dllgxhy/ElectriSmell/hardware/v50/工作流程图.pdf

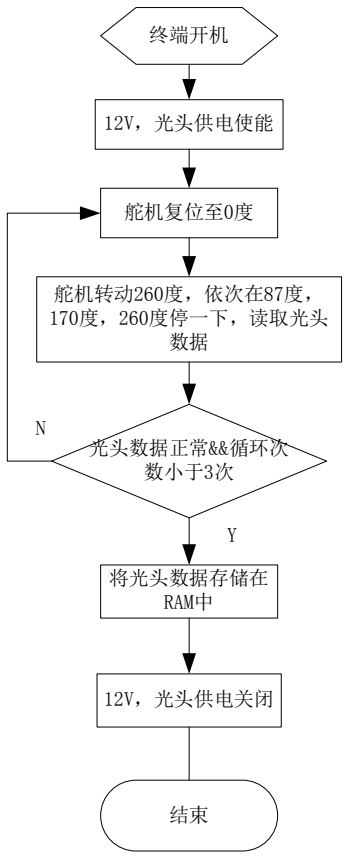
[picture p2: figure]
终端开机; 舵机复位至0度; 舵机转动260度，依次在87度， 170度，260度停一下，读取光头 数据; 光头数据正常&&循环次 数小于3次; 将光头数据存储在 RAM中; 12V，光头供电使能; 12V，光头供电关闭

开机流程

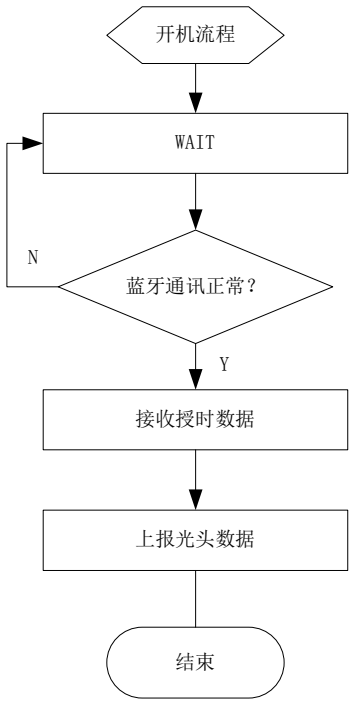
[picture p3: figure]
开机流程; 蓝牙通讯正常？; WAIT; 接收授时数据; 上报光头数据

接收

蓝牙联通流程

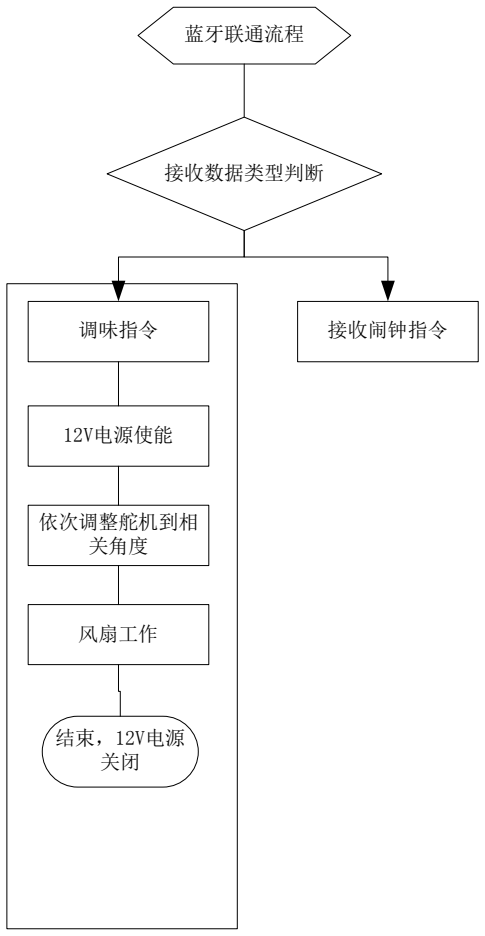
[picture p4: figure]
蓝牙联通流程; 接收数据类型判断; 调味指令; 接收闹钟指令; 12V电源使能; 依次调整舵机到相 关角度; 风扇工作; 结束，12V电源 关闭

调味流程中的每个流程都可以被蓝牙数据打断，重新工作

如：控制3个舵机全部转到260度，风扇需工作时间180s，目 前舵机已转到位置，风扇工作了15s,而此时蓝牙端接收到命 令 控制舵机转到177度，风扇工作70s，则此时执行新命令
