dllgxhy/ElectriSmell/hardware/v30/bom.xls

物料清单
文件编号: |  |  | 文件版本:V1.0
主板模块V2.0 物料编码: |  |  |  |  |  | 购买链接 | 单价 | 采购数量
1 | PCB |  |  | 1
电容
2 | 电容 | 100nF ±10% 0603 | C25,C27,C29,C38,C40,C44,C48,C50,C53,C25,C27,C29,C38,C40,C44,C48,C50,C53,C57 | 19 |  | http://www.szlcsc.com/product/details_2040.html | 24.8元/盘 | 300 | ok
4 | 电容 | 10nF ±10% 0603 | C7,C8,C24 | 3 |  | http://www.szlcsc.com/product/details_27151.html | 29元/盘 | 100 | ok
6 | 电容 | 100pF ±20% 50v 0603 | C13 | 1 |  | http://www.szlcsc.com/product/details_45569.html | 24.8元/盘 | 150 | ok
7 | 电容 | 10uF ±%10 0603 | C9,C10,C26,C28,C30,C37,C39,C41,C42,C45,C46,C51,C54,C56,C58,C60,C17,C19,C21,C23 | 20 |  | http://www.szlcsc.com/product/details_2043.html | 94元/盘 | 300 | ok
8 | 电容 | 1uF ±10% 0603 | C16,C18,C20,C22,C43,C47,C52,C55,C59 | 9 |  | http://www.szlcsc.com/product/details_37555.html | 22元/盘 | 200 | ok
9 | 电容 | 20pF ±5% 0603 | C11,C14 | 2 |  | http://www.szlcsc.com/product/details_2000.html | 23.2元/盘 | 200 | ok
12 | 电容 | 6.2pF ±5% 0603 | C12,C15 | 2 |  | http://www.szlcsc.com/product/details_2030.html | 24.8元/盘 | 100 | OK
电阻
13 | 电阻 | 300Ω ±5% 0603 | R49 | 1 |  | http://www.szlcsc.com/product/details_25972.html | 11元/盘 | 100 | OK
14 | 电阻 | 3.9KΩ ±5% 0603 | R48 | 1 |  | http://www.szlcsc.com/product/details_26740.html | 11元/盘 | 100 | OK
15 | 电阻 | 0Ω ±5% 0603 | R23,R29,R33,R18,R19,R22,R25,R26,R28,R32 | 10 |  | http://www.szlcsc.com/product/details_16080.html | 11元/盘 | 200 | OK
16 | 电阻 | 0Ω ±5% 0805 | R47 | 1 | 正式使用时不焊接 | http://www.szlcsc.com/product/details_26018.html | 21 | 100 | OK
17 | 电阻 | 100K ±1% 0603 | R24,R30,R34 | 3 |  | http://www.szlcsc.com/product/details_16137.html | 18.5/盘 | 100 | OK
18 | 电阻 | 100Ω ±1% 0603 | R39,R41,R44,R50 | 4 |  | http://www.szlcsc.com/product/details_23502.html | 13/盘 | 200 | OK
21 | 电阻 | 10KΩ ±1% 0603 | R46,R10,R11,R12,R14,R15,R16,R17 | 8 |  | http://www.szlcsc.com/product/details_16079.html | 11/盘 | 200 | OK
22 | 电阻 | 330Ω ±5% 0603 | R40,R42,R45 | 3 |  | http://www.szlcsc.com/product/details_25974.html | 11/盘 | 100 | OK
23 | 电阻 | 220K ±5% 0603 | R43 | 1 |  | http://www.szlcsc.com/product/details_26330.html | 11/盘 | 100 | OK
24 | 电阻 | 1MΩ ±5% 0603 | R20 | 1 |  | http://www.szlcsc.com/product/details_26841.html | 11/盘 | 100 | OK
25 | 磁珠 | 100M 600Ω DCR<0.2ohm L0603 | L1 | 1 |  | http://www.szlcsc.com/product/details_29860.html | 53.6/盘 | 50 | OK
26 | LED | LED 蓝色 0603 | D9 | 1 |  | http://www.szlcsc.com/product/details_2661.html | 112/盘 | 40 | OK
27 | LED | LED 红色 0603 | D5,D7,D8,D6 | 4 |  | http://www.szlcsc.com/product/details_2659.html | 83.2/盘 | 100 | OK
28 | 晶振 | 8MHz,DIP,CL=8PF,HC49US | Y5 | 1 |  | http://www.szlcsc.com/product/details_21980.html | 50.4/盘 | 10 | OK
29 | 晶振 | 32.768KHz,3215 10ppm 12.5PF SMD | Y4 | 1 |  | http://www.szlcsc.com/product/details_71788.html | 189/盘 | 10
30 | 二极管 | RB160M-40 SOD123 | D2,D3,D4 | 3 |  | http://www.szlcsc.com/product/details_22279.html | 498/盘 | 50
IC
31 | PMU模块 | LM2577_M | U14 | 1 | 不焊接
32 | LDO | 78L05 SOT89 | U12 | 1 |  | http://www.szlcsc.com/product/details_43729.html | 1元/片 | 10 | OK
33 | LDO | ME6206A33 SOT23 | U11,U13,U15 | 3 |  | http://www.szlcsc.com/product/details_36232.html | 1元/片 | 10 | OK
34 | 充电IC | LN2054 | U10 | 1
35 | 模块 | BLE模块 | U7 | 1 | 不焊接
36 | 电机驱动芯片 | L9110S,SOP8 | U6,U8,U9 | 3 |  | https://detail.tmall.com/item.htm?id=40638558550&rn=196c9fb2bf3e426f6890c259c679c593&abbucket=13 | 6.5元/片 | 20 | OK
37 | 总线驱动芯片 | 74LVC4245A,TSSOP24 | U5 | 1 |  | http://www.szlcsc.com/product/details_6557.html | 2.39元/片 | 10 | OK
38 | MCU | STM32F103RCT6TR LQFP64 | U4 | 1 |  | https://detail.tmall.com/item.htm?id=19294790966&rn=550d37b9a9447904c1c20e33544b37f7&abbucket=13 | 16.46元/片 | 10 | OK
其他
39 | 按键 | 轻触开关 3*6*4.3mm SMD 250g | PWR1 | 3
40 | 按键 | 微型按钮自锁开关直插2脚带锁轻触按键开关电源8*8 | J15 | 3 | 不焊接 | https://item.taobao.com/item.htm?spm=a230r.1.14.16.pVWdSJ&id=522739128532&ns=1&abbucket=3#detail | 1.5元/个 | 20
41 | USB连接器 | MICRO-B-5P SMD | J13 | 1 |  | http://www.szlcsc.com/product/details_10961.html | 0.384元/个 | 10 | OK
42 | 锂电池 | RP601752P 500mAH(带保护板) | J12 | 1
43 | 舵机 |  | M1,M2,M3 | 3 | 不焊接
44 | 风扇 |  | J3,J4,J5 | 3 | 不焊接
45 | JTAG连接座 |  | J1 | 1 | 不焊接
固件程序:
程序名 | 固件版本号 |  | 烧写方式 |  | 备注
预装的文件
修 改 历 史 记 录
版本 | 修改日期 | 修改內容 |  |  | 备注
拟制: |  | 审核: | 批准:
