dllgxhy/ElectriSmell/hardware/v30/ELECTRISMELL0504.dxf

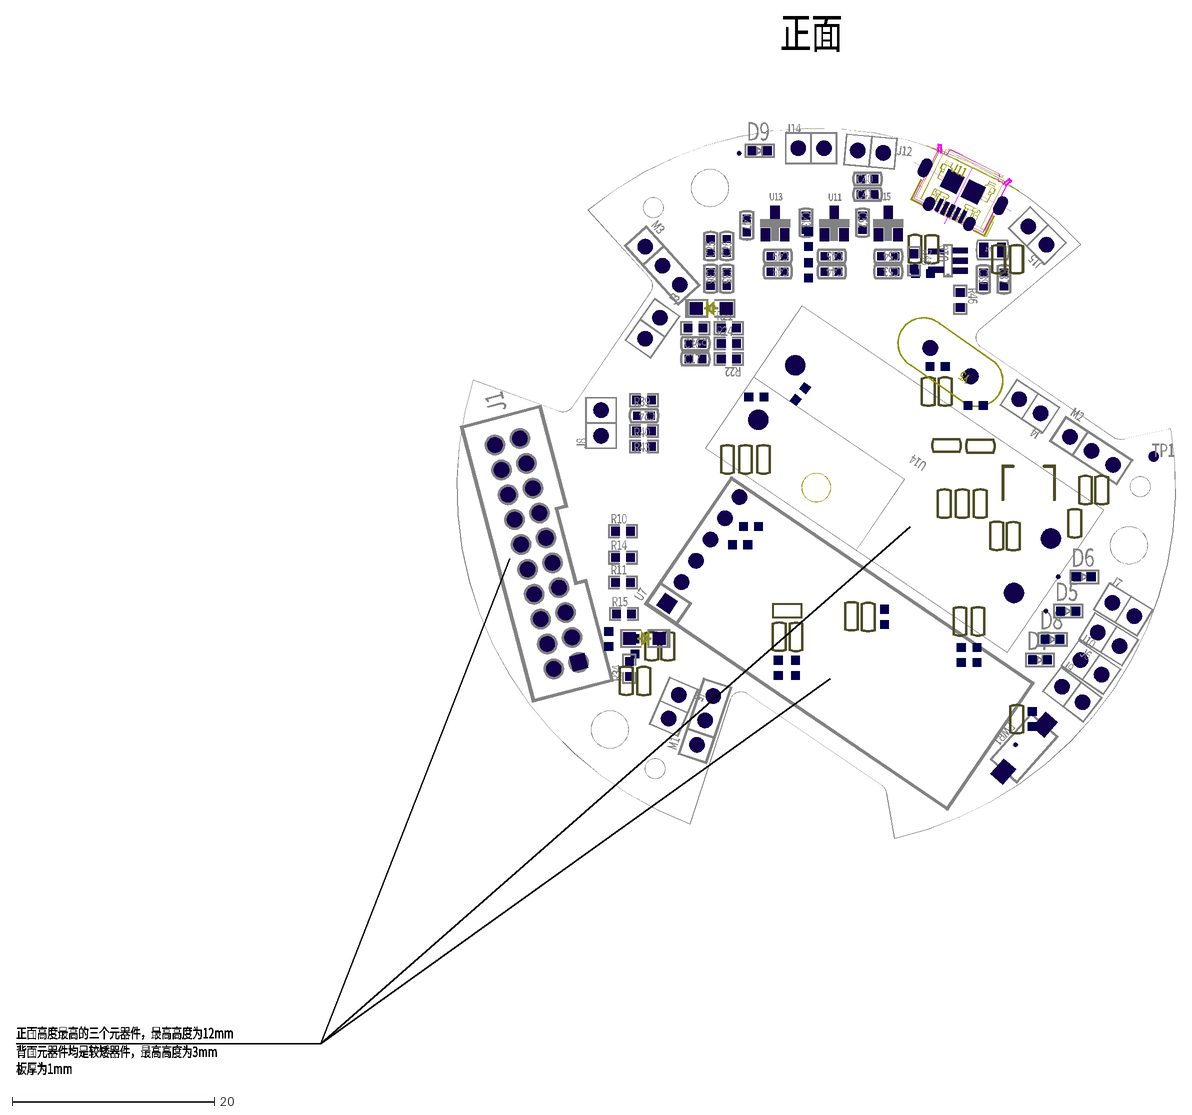
[picture p5: CAD file, 2016-07-26, an earlier design]
hardware/v30/ELECTRISMELL0504.dxf
J1
2
5
1
3
S2
S1
S3
S4
4
J11
U10
U14
U7
M1
M2
M3
PWR1
C16
C17
C24
C35
C36
J10
J12
J3
J4
J5
J6
J7
J8
J9
R10
R11
R14
R15
R39
R40
R43
R47
TP1
U11
U13
U15
Y5
J14
J15
R21
R34
C25
C26
C37
C39
C40
C41
C43
C44
C45
C47
C48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
