dllgxhy/ElectriSmell/hardware/v40/ELECTRISMELL_V40.dxf

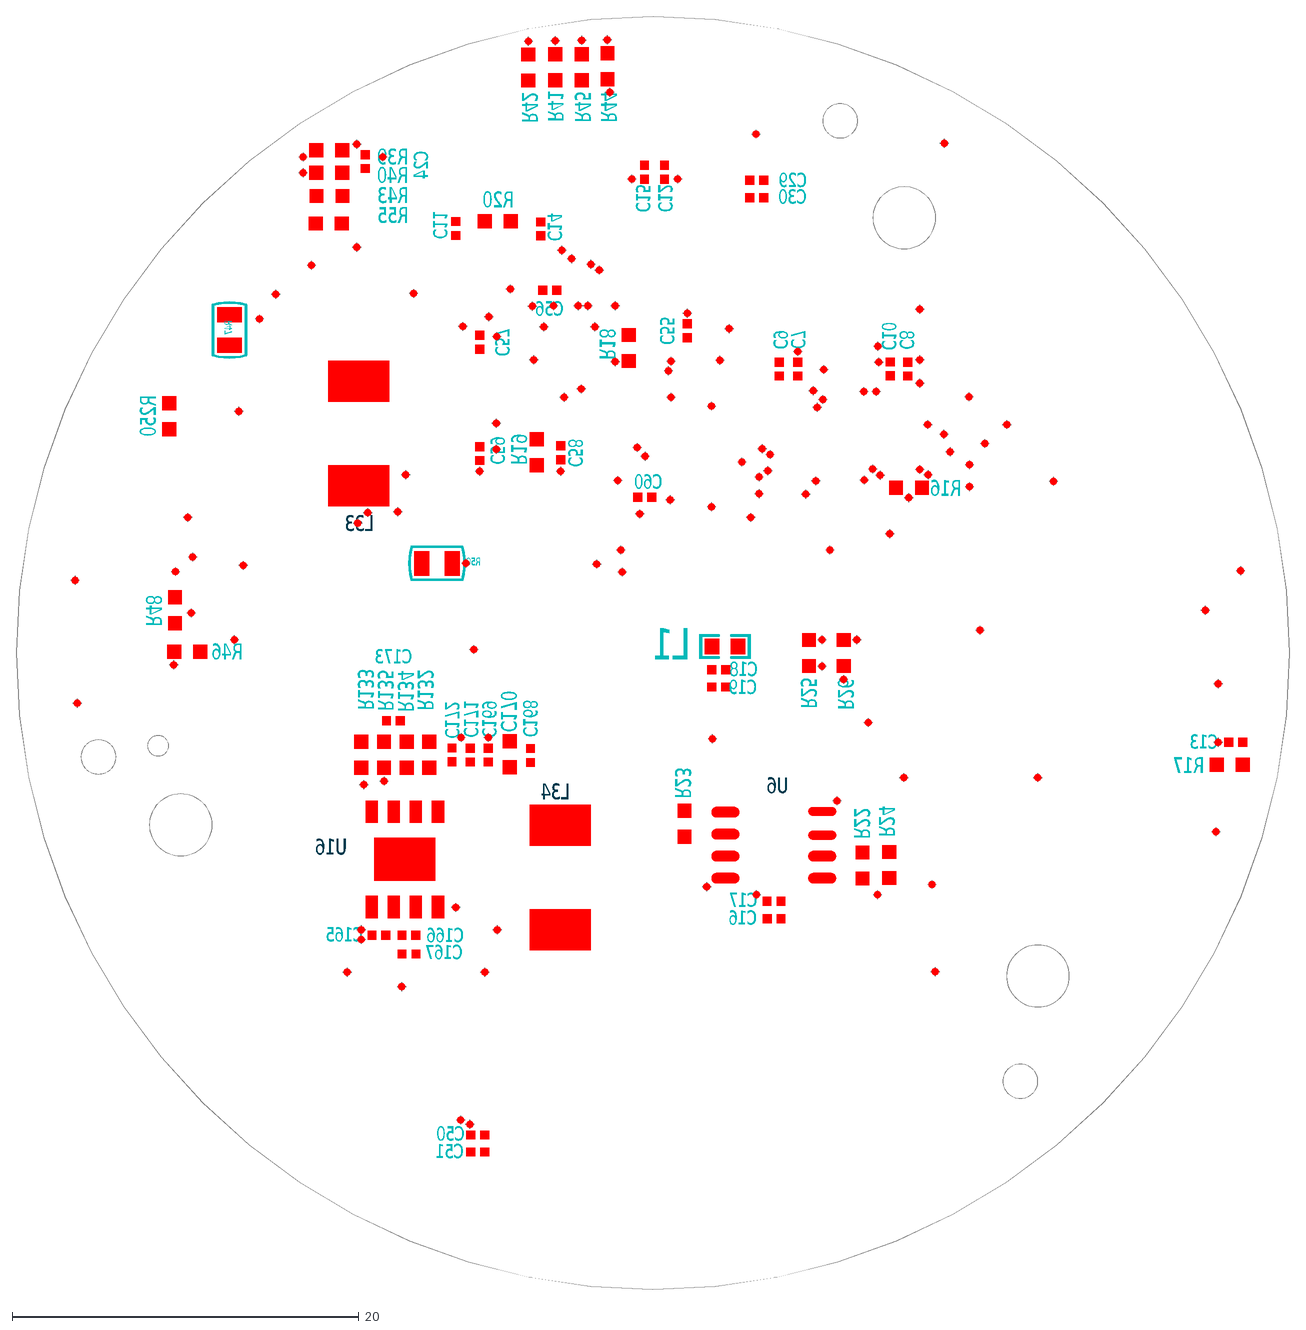
[picture p6: CAD file, 2016-07-26, an earlier design]
hardware/v40/ELECTRISMELL_V40.dxf
R39
C24
R43
R40
R55
C10
C11
C12
C13
C14
C15
C16
C165
C166
C167
C168
C169
C17
C170
C171
C172
C173
C18
C19
C29
C30
C50
C51
C55
C56
C57
C58
C59
C60
C7
C8
C9
L1
L33
L34
R132
R133
R134
R135
R16
R17
R18
R19
R20
R22
R23
R24
R25
R250
R26
R41
R42
R44
R45
R46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
