dllgxhy/ElectriSmell/hardware/v30/electrismell.pdf

D | D

# S T M3 2

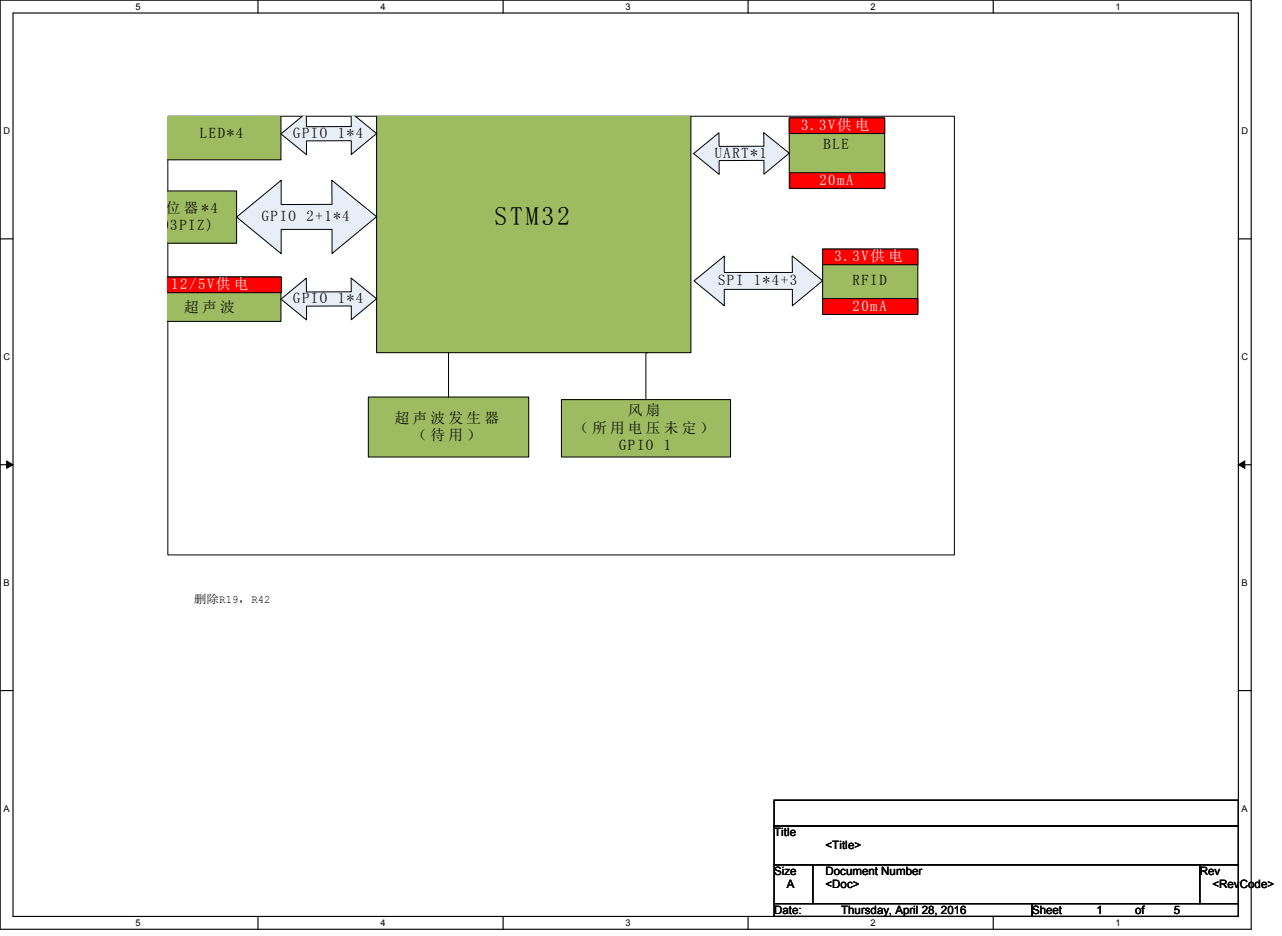
[picture p7: page 1]
UART*1; SPI 1*4+3; GPIO 1*4; GPIO 2+1*4; 删除R19，R42; Title; Size; Document Number; Rev; Date:; Sheet; <Doc>; <RevCode>; <Title>; Thursday, April 28, 2016

### JNTRST JTDI

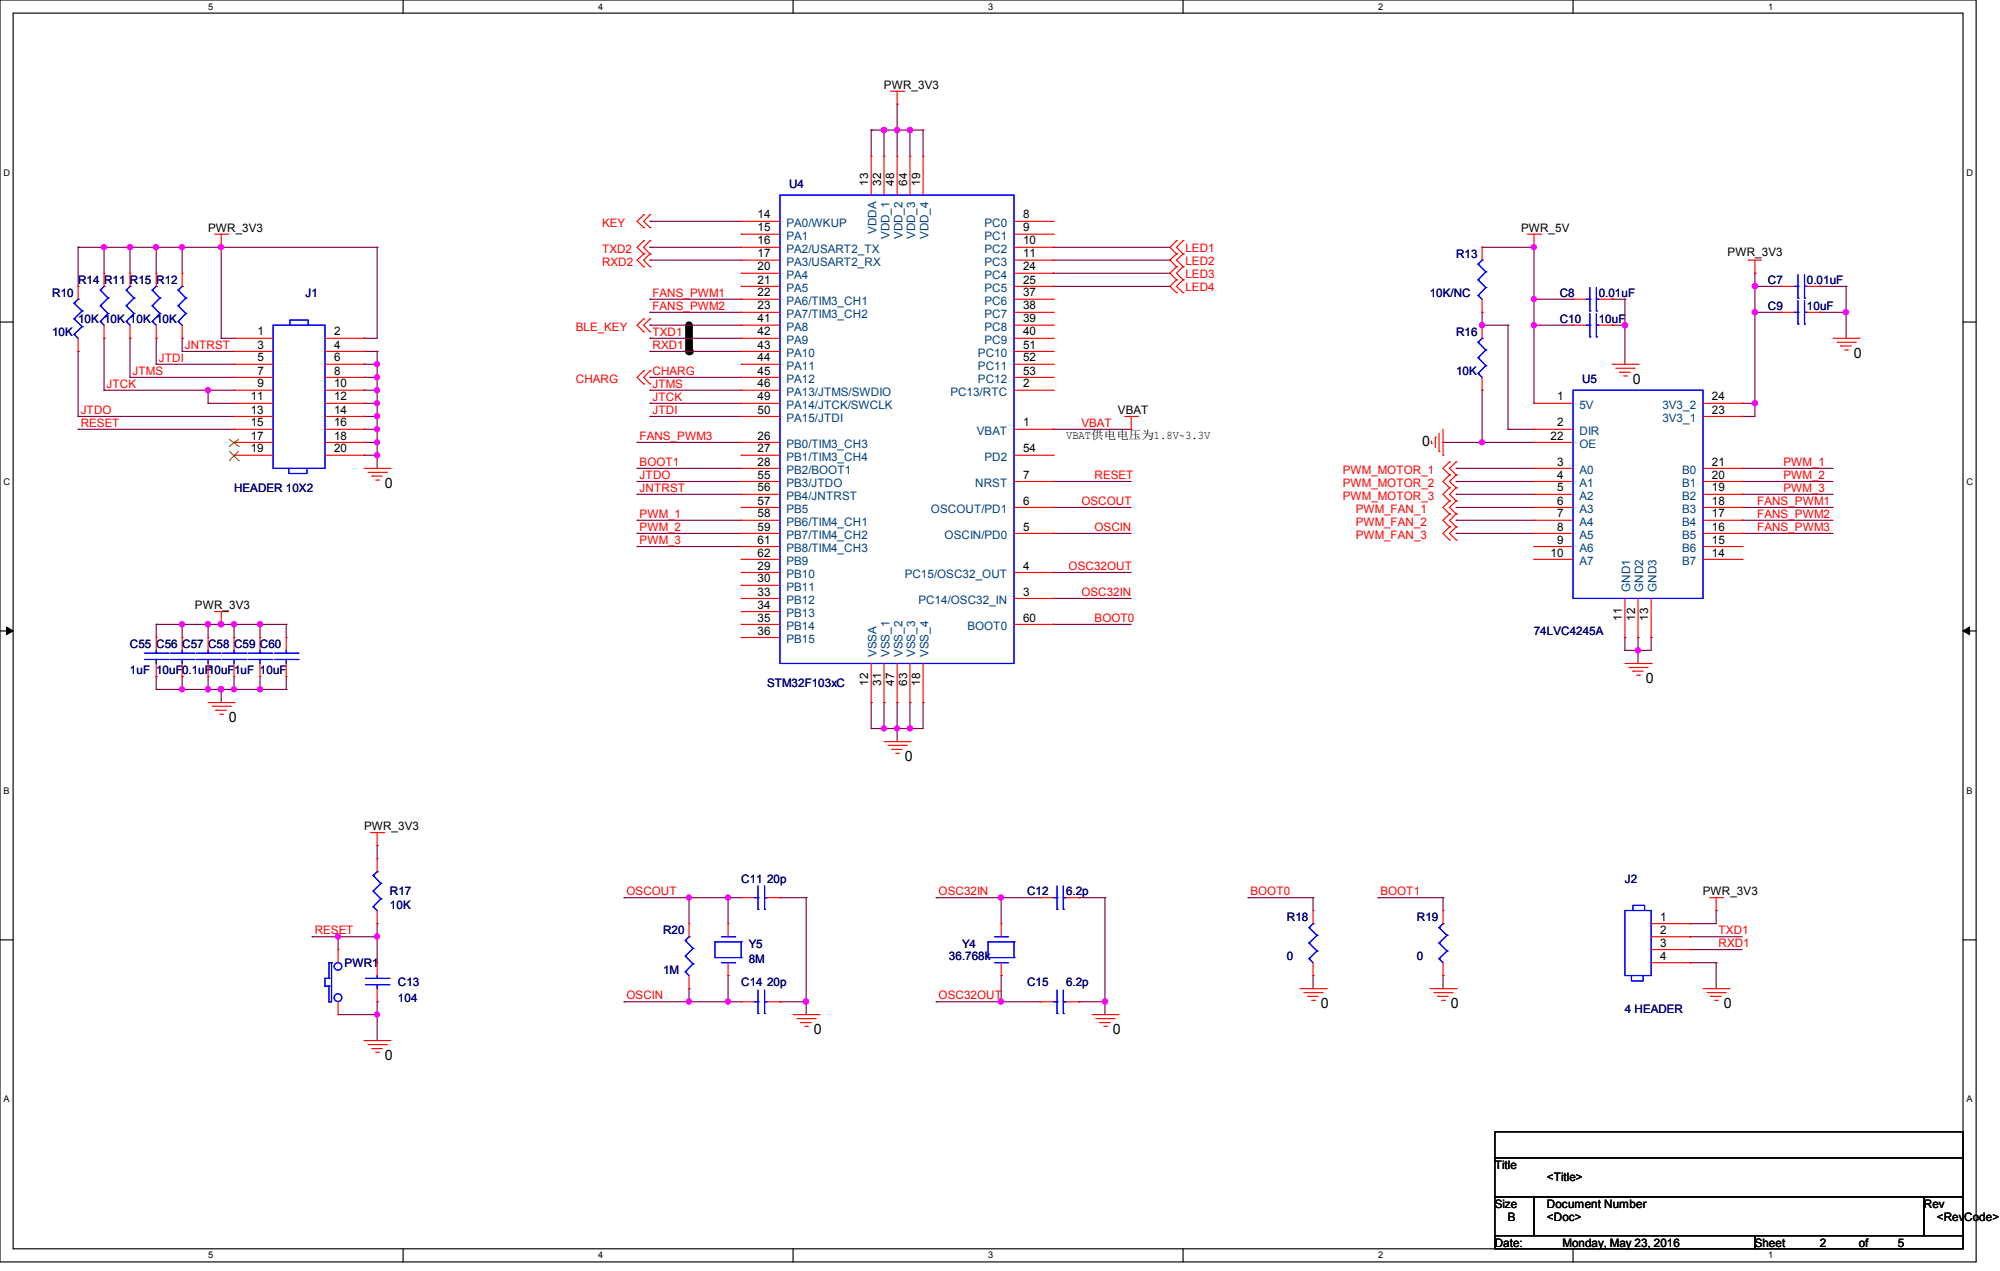
[picture p8: page 2]

# 风扇驱动电路1

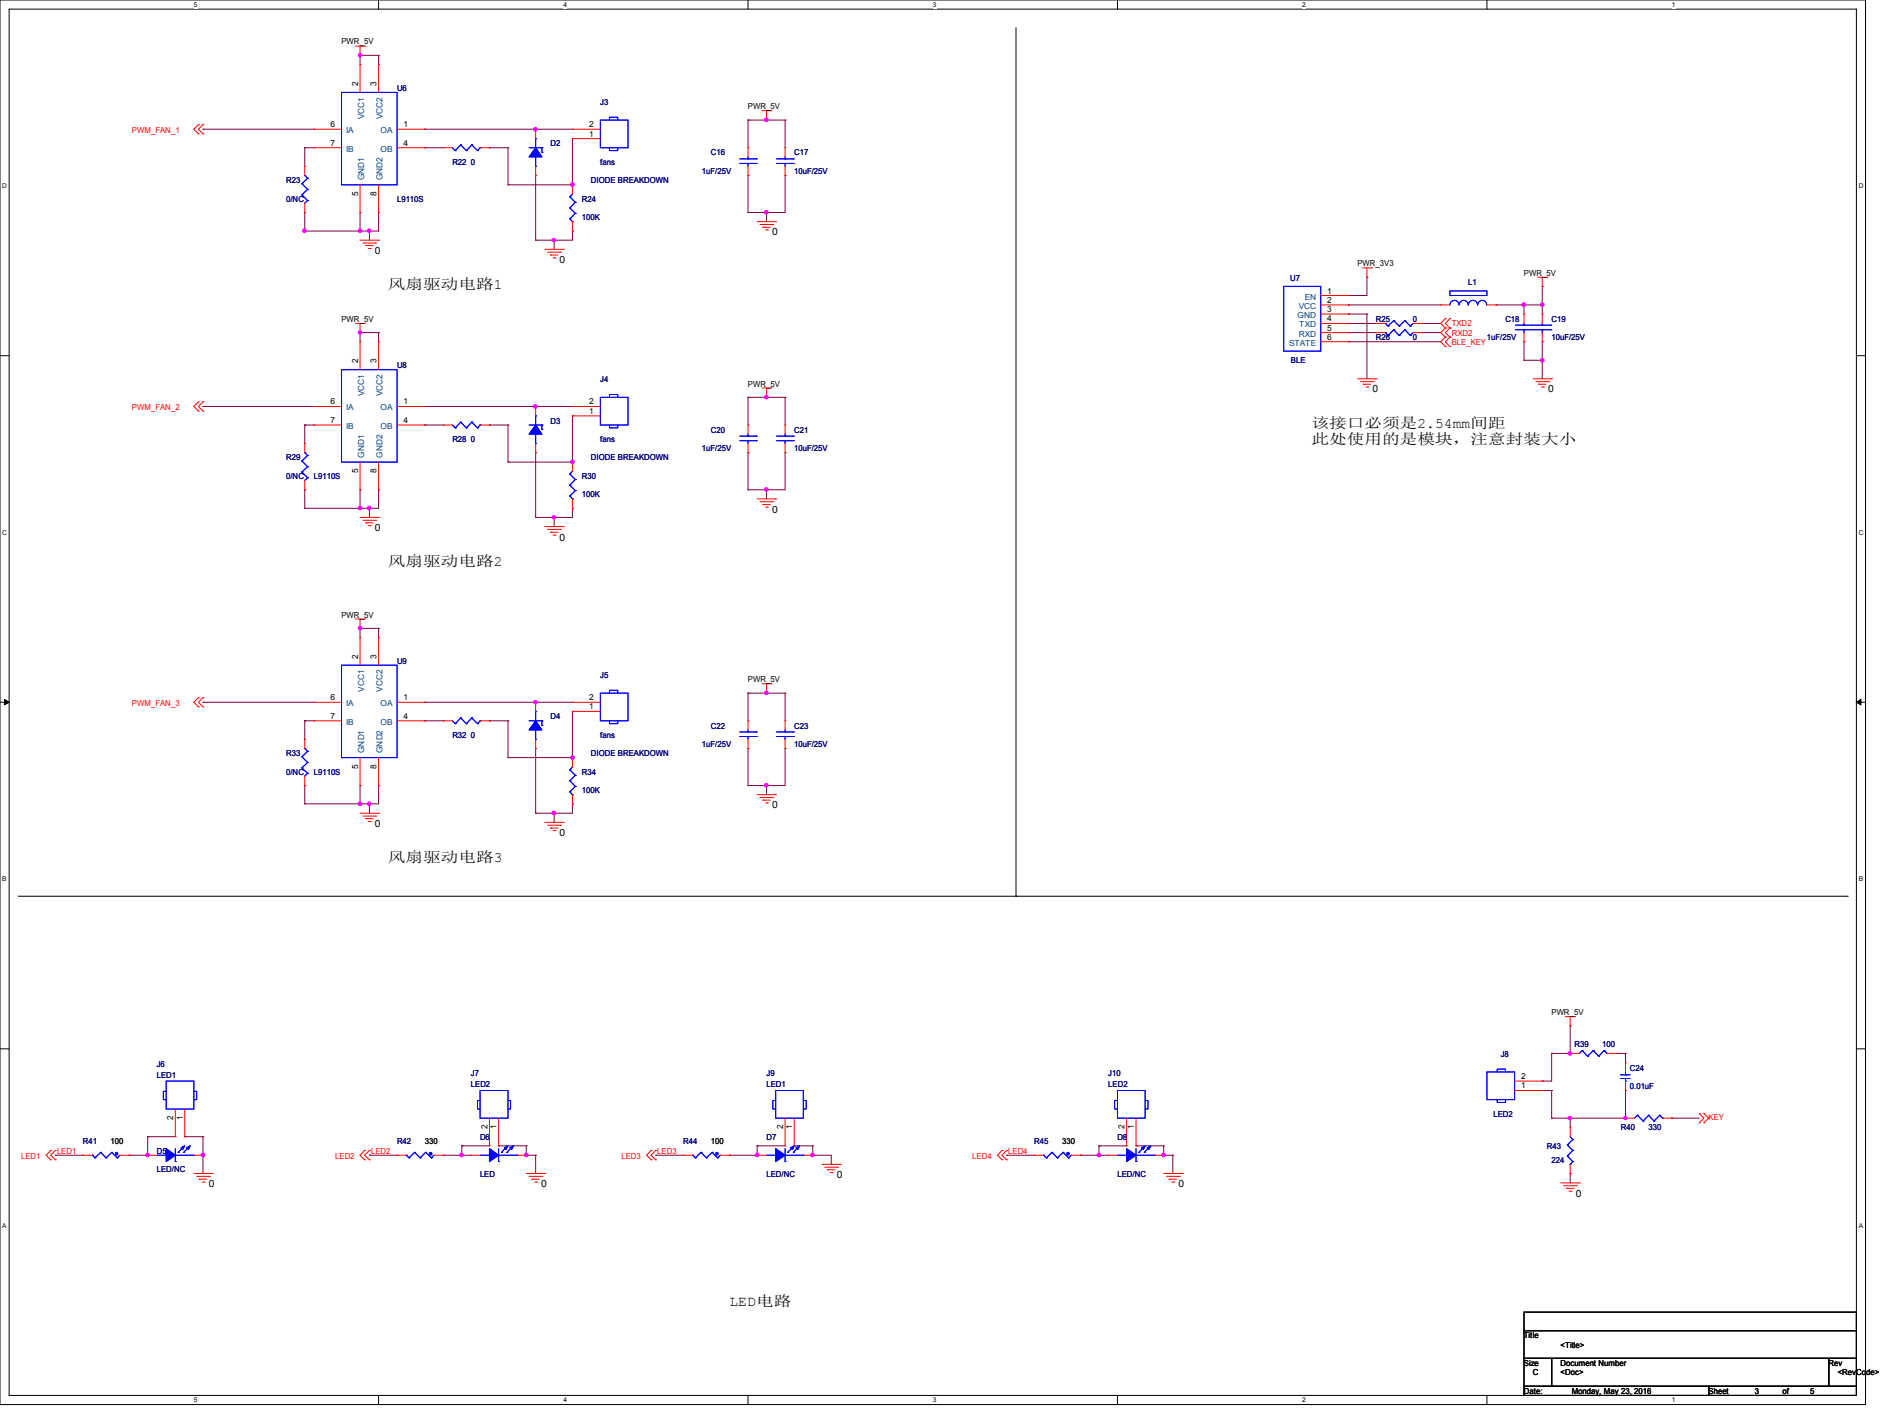
[picture p9: page 3]

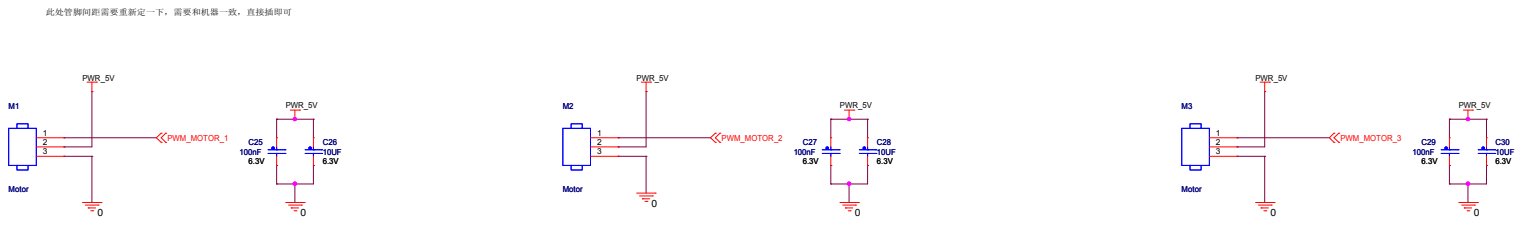
[picture p10: page 4]
PWR_5V; PWM_MOTOR_1; PWM_MOTOR_2; PWM_MOTOR_3; Wednesday, May 04, 2016; Motor

此处管脚间距需要重新定一下，需要和机器一致，直接插即可

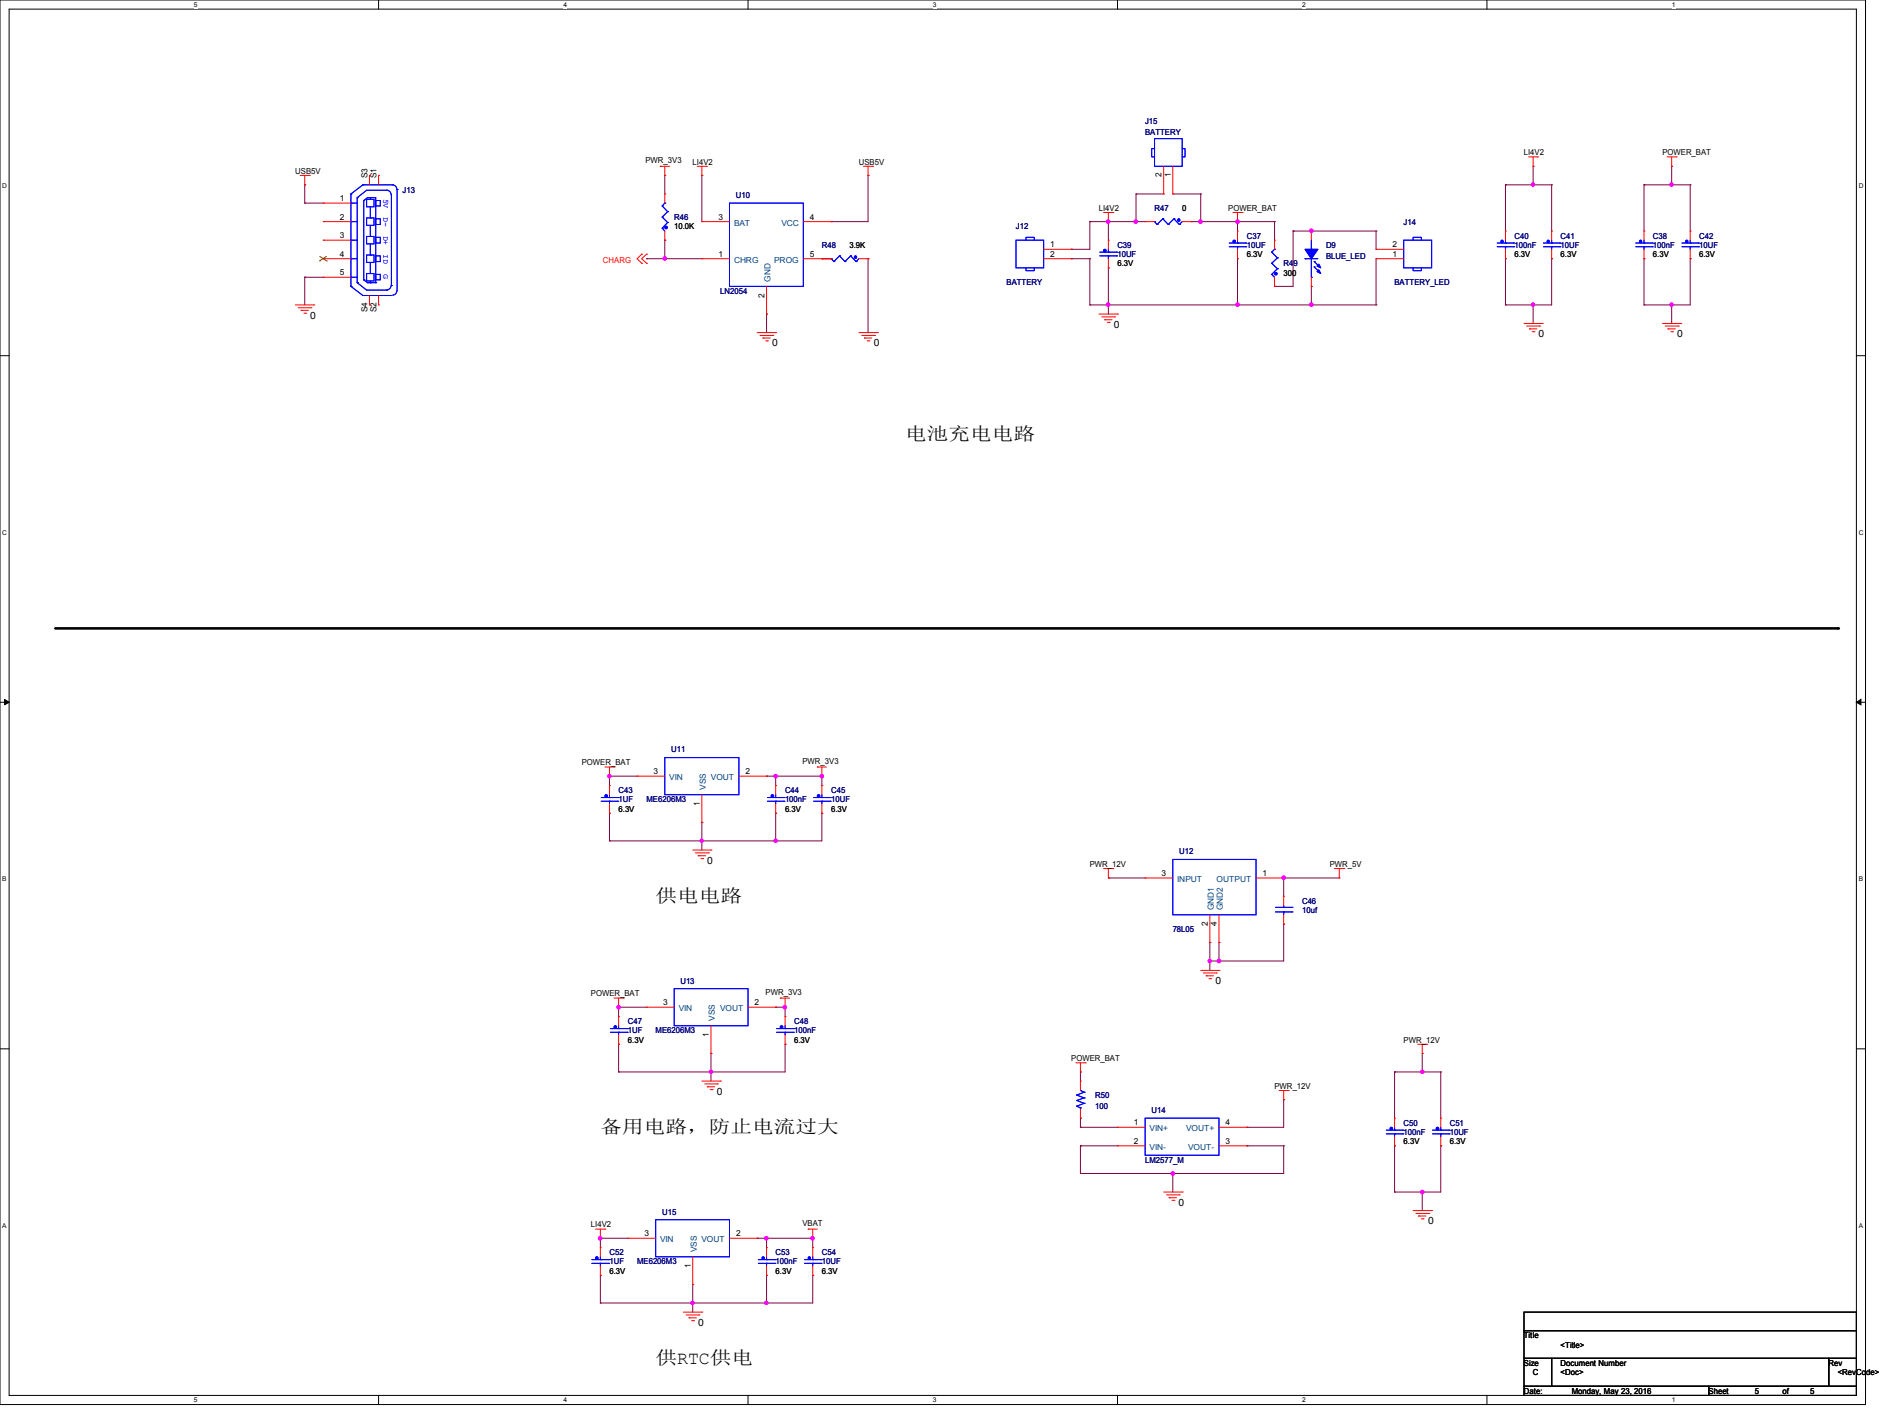
[picture p11: page 5]
