dllgxhy/ElectriSmell/hardware/v40/electrismell_v40.pdf

D | D

# S T M3 2

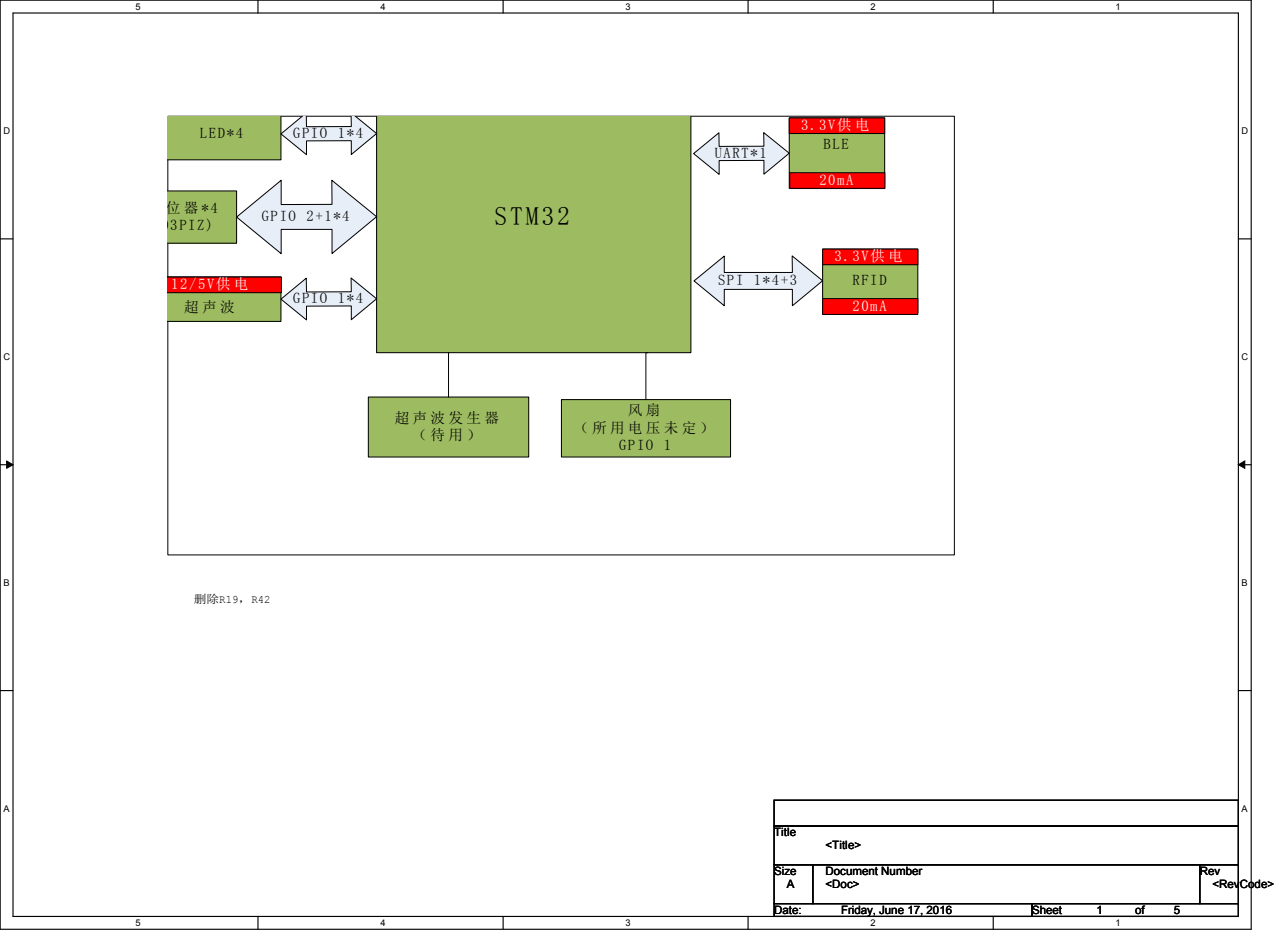
[picture p12: page 1]
UART*1; SPI 1*4+3; GPIO 1*4; GPIO 2+1*4; 删除R19，R42; Title; Size; Document Number; Rev; Date:; Sheet; <Doc>; <RevCode>; <Title>; Friday, June 17, 2016

### JNTRST JTDI

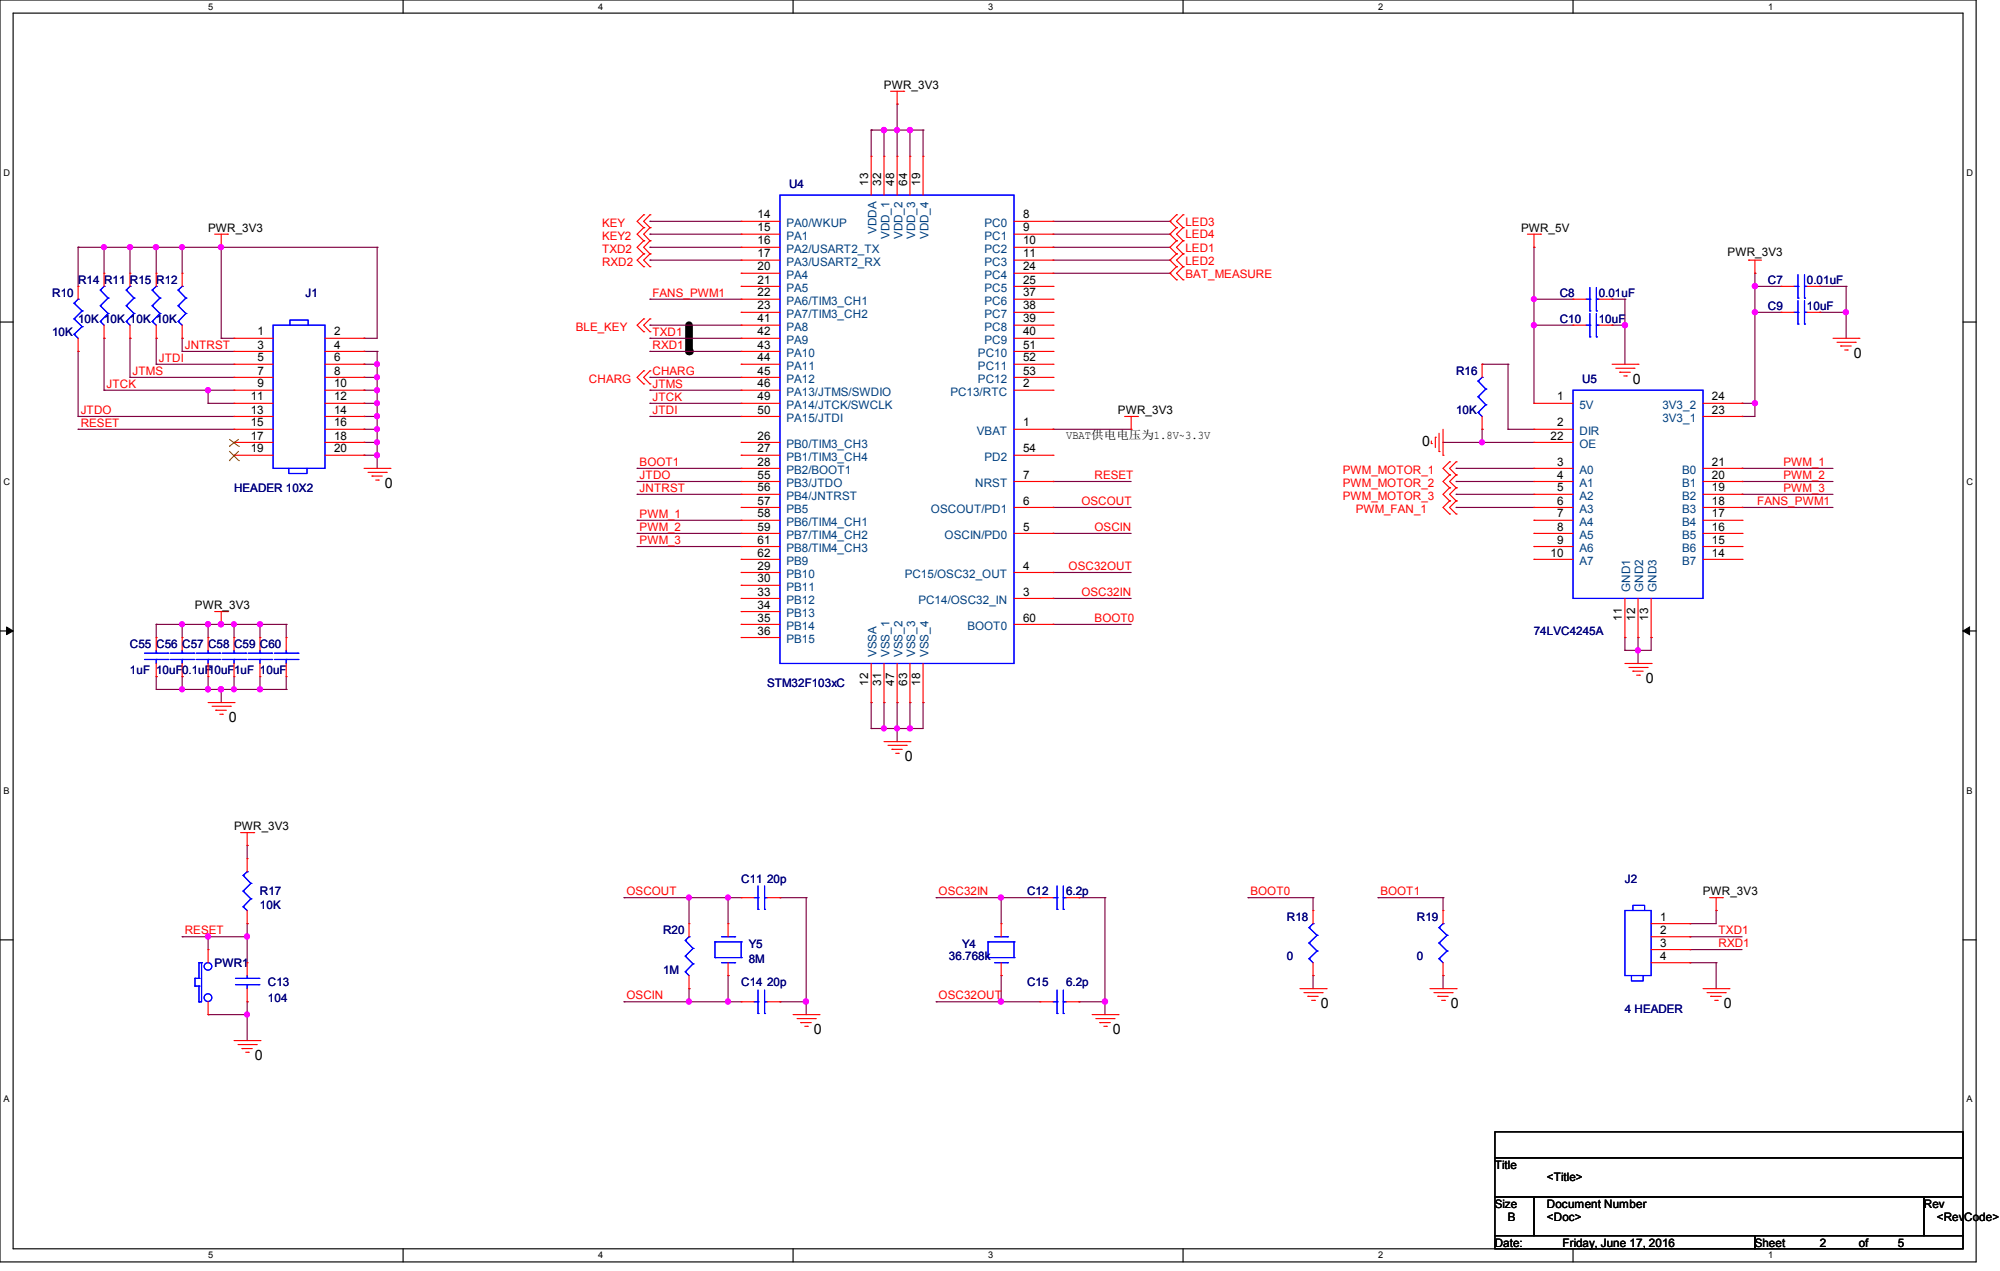
[picture p13: page 2]

## err: TX 与RX连反了

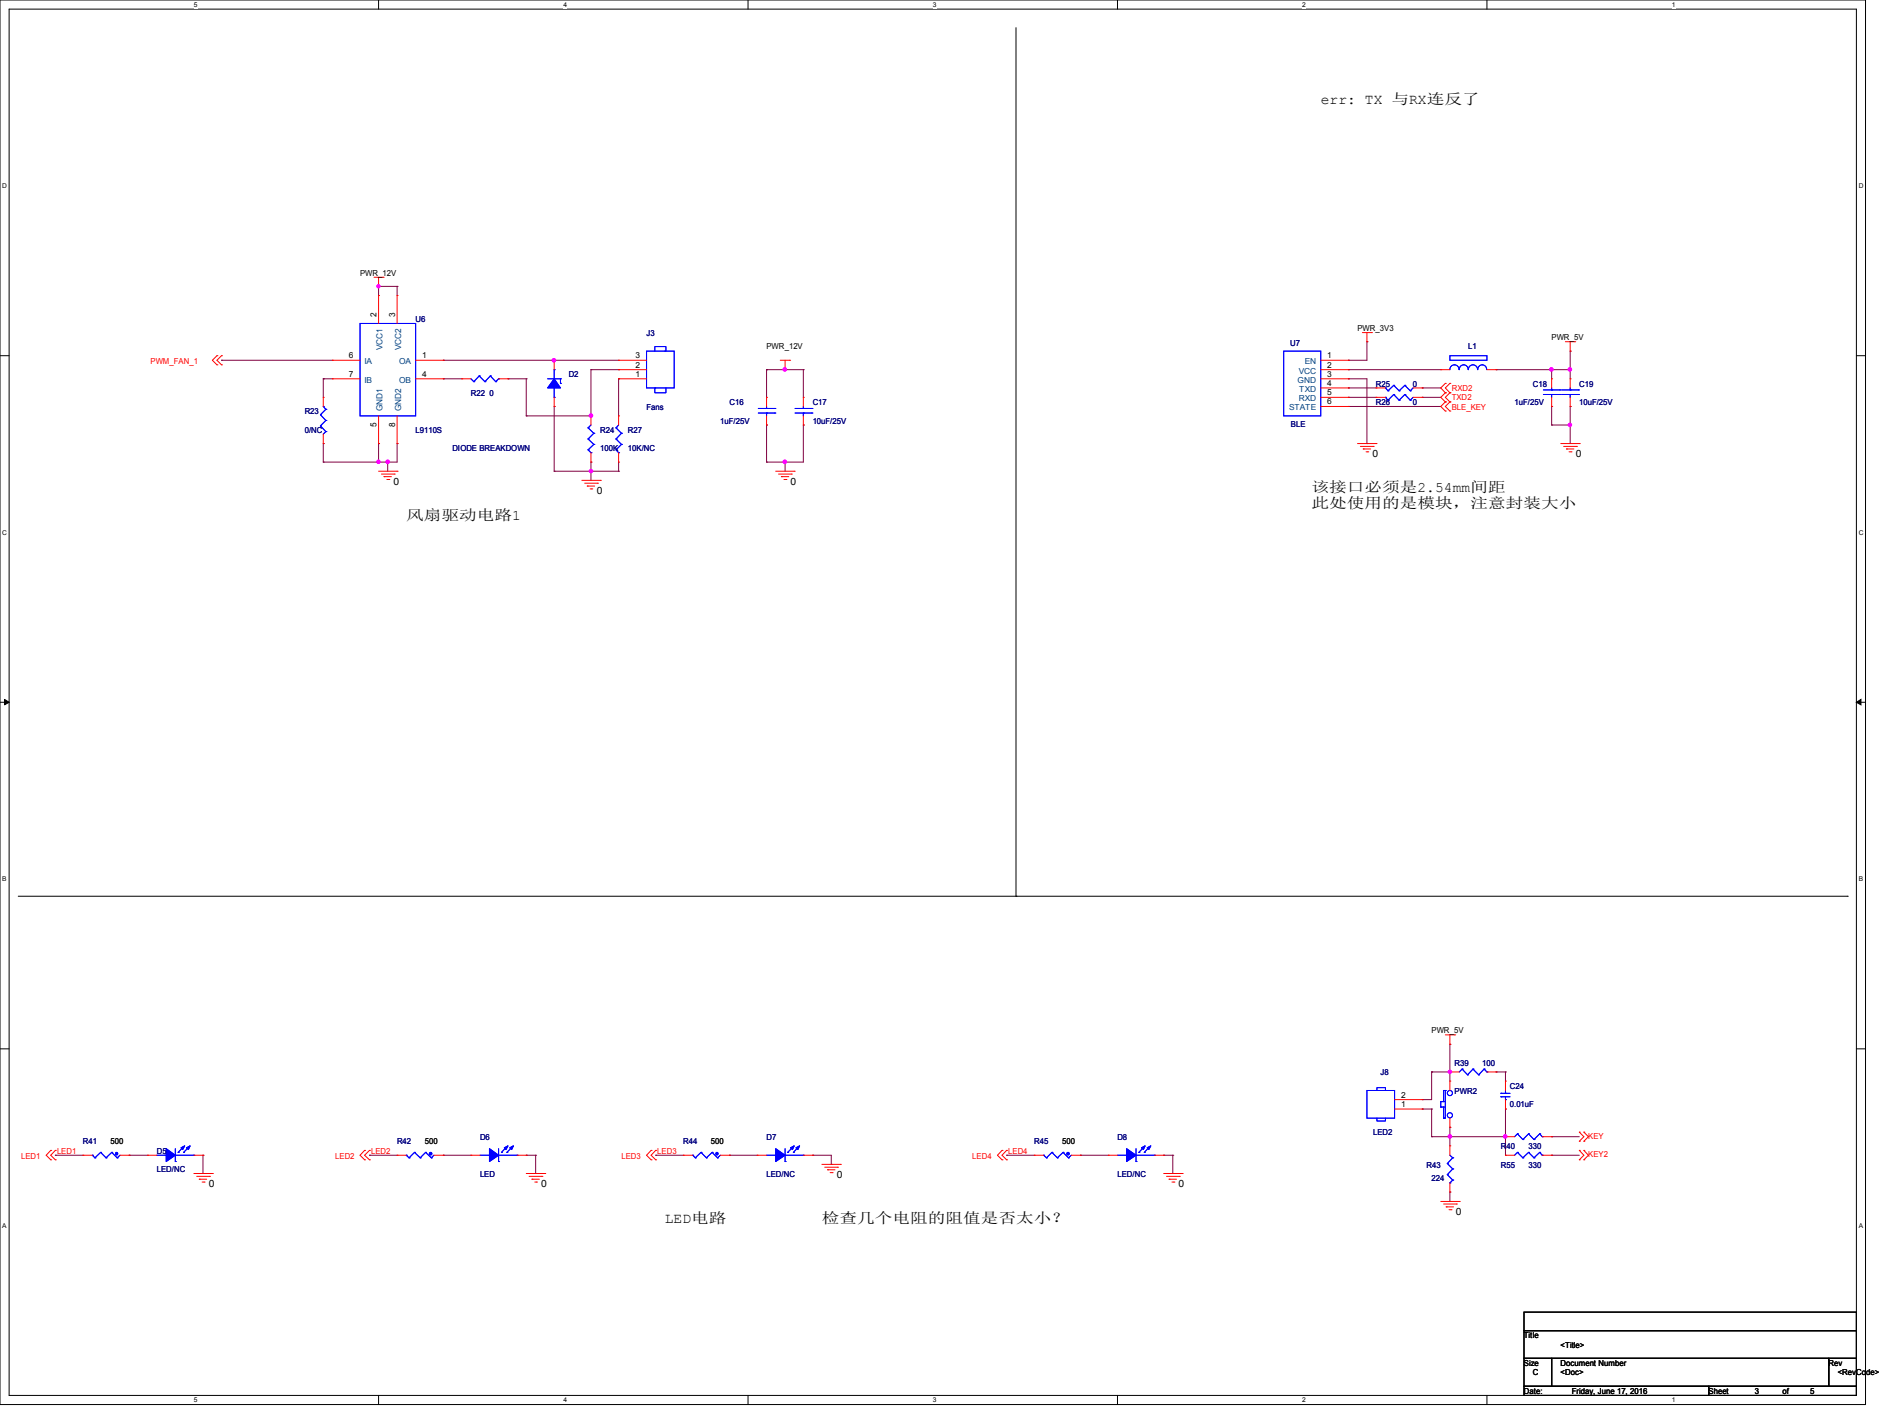
[picture p14: page 3]

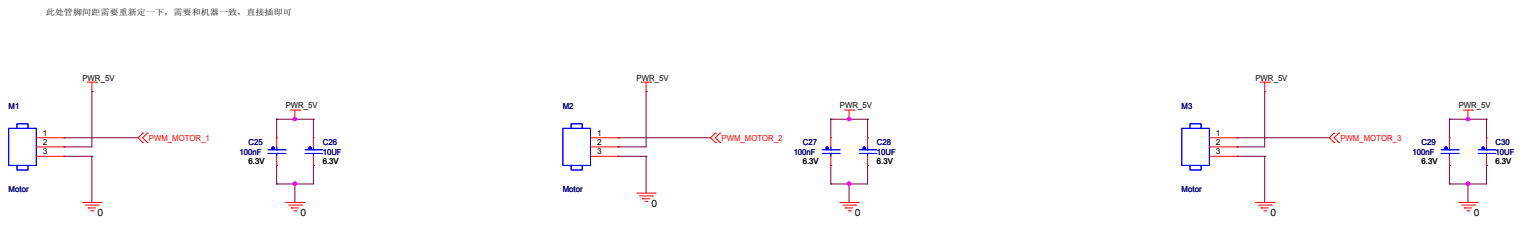
[picture p15: page 4]
PWR_5V; PWM_MOTOR_1; PWM_MOTOR_2; PWM_MOTOR_3; Friday, June 17, 2016; Motor

此处管脚间距需要重新定一下，需要和机器一致，直接插即可

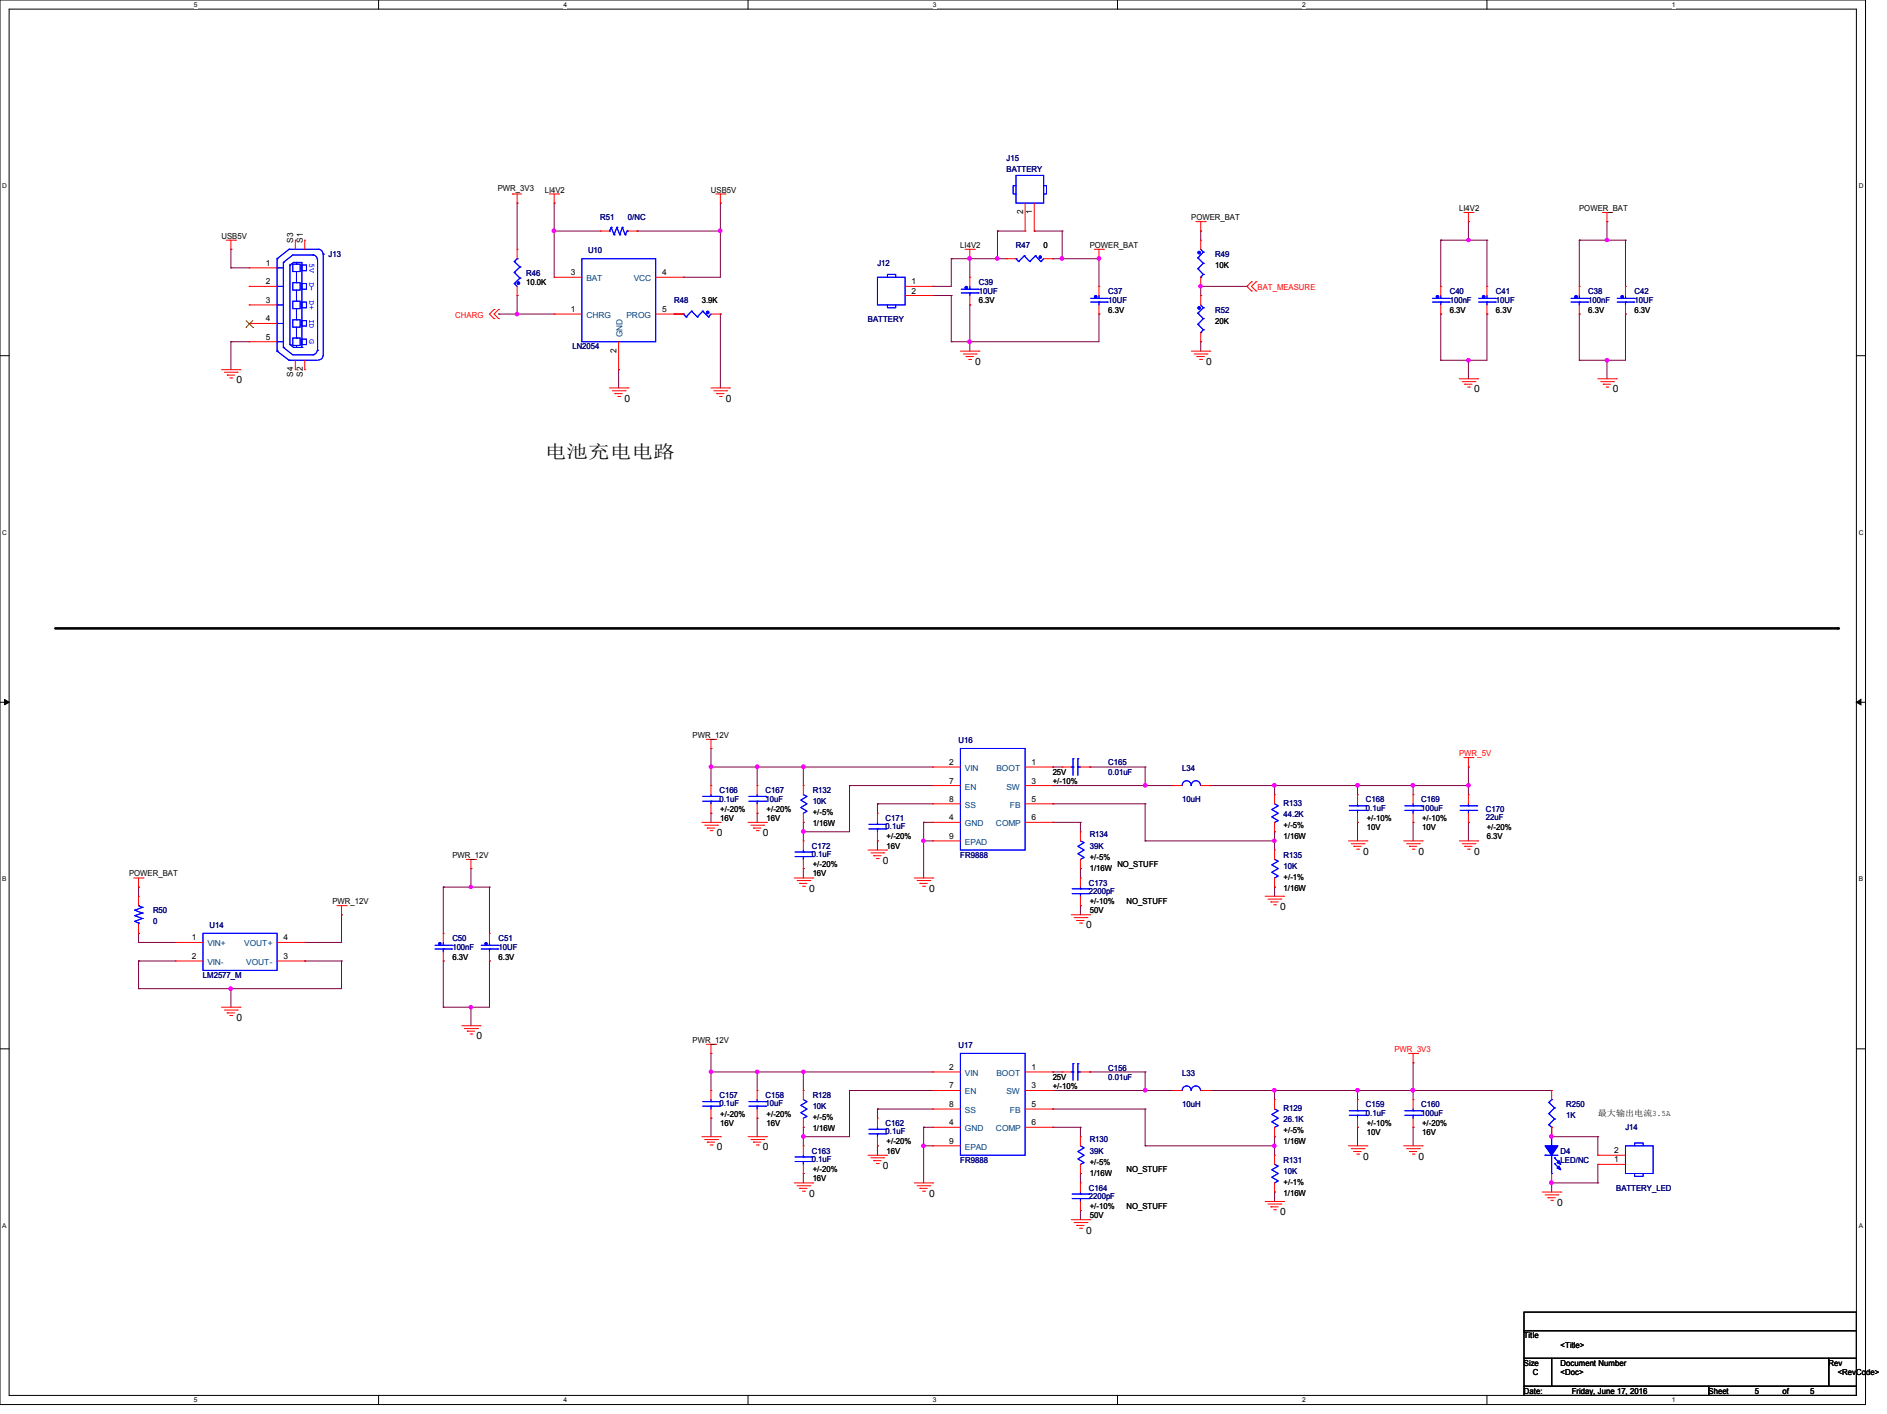
[picture p16: page 5]
