dllgxhy/ElectriSmell/hardware/v50/elesmell_v50.pdf

D | D

# SERVO

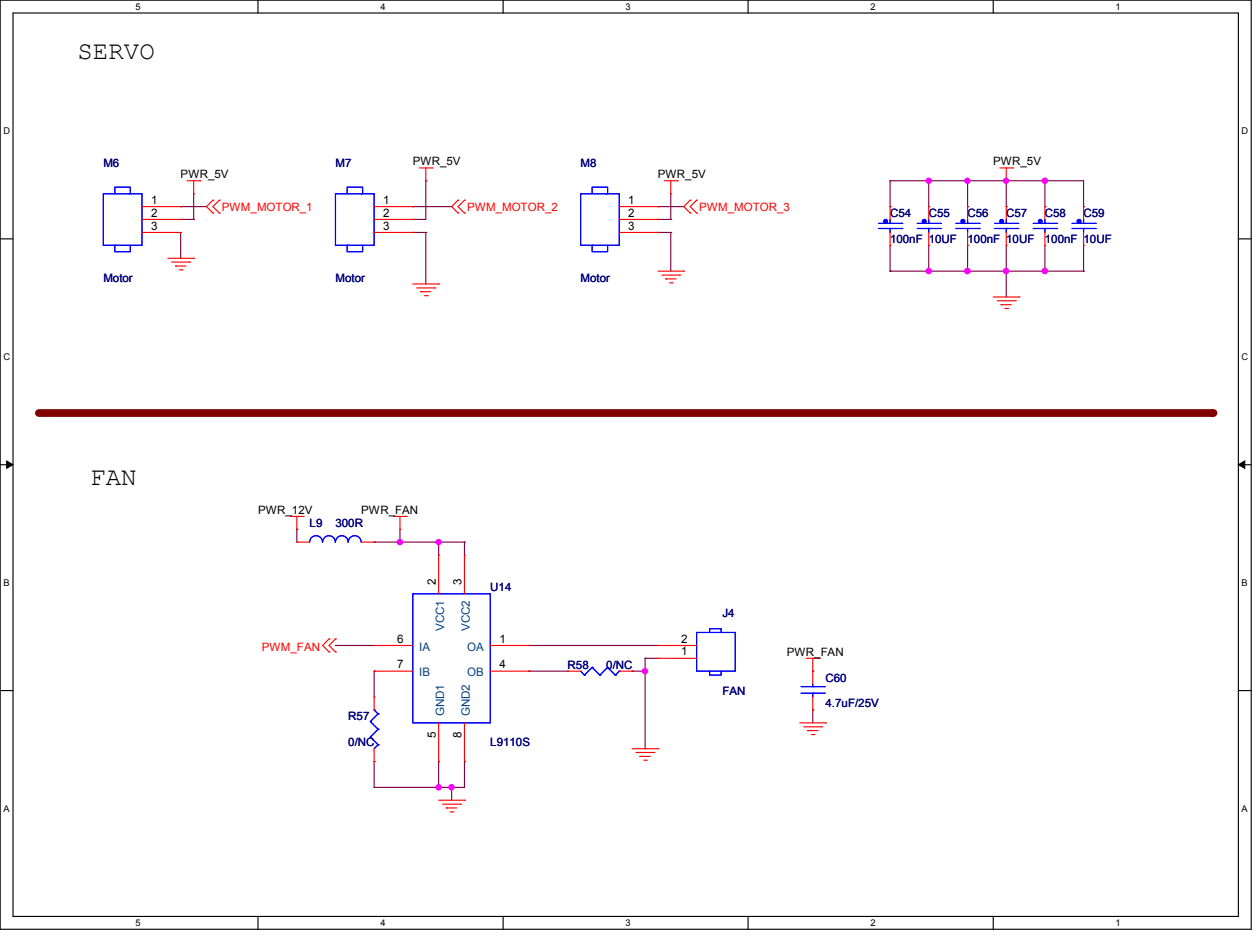
[picture p17: page 1]

USB&CHARGE | 升压电路

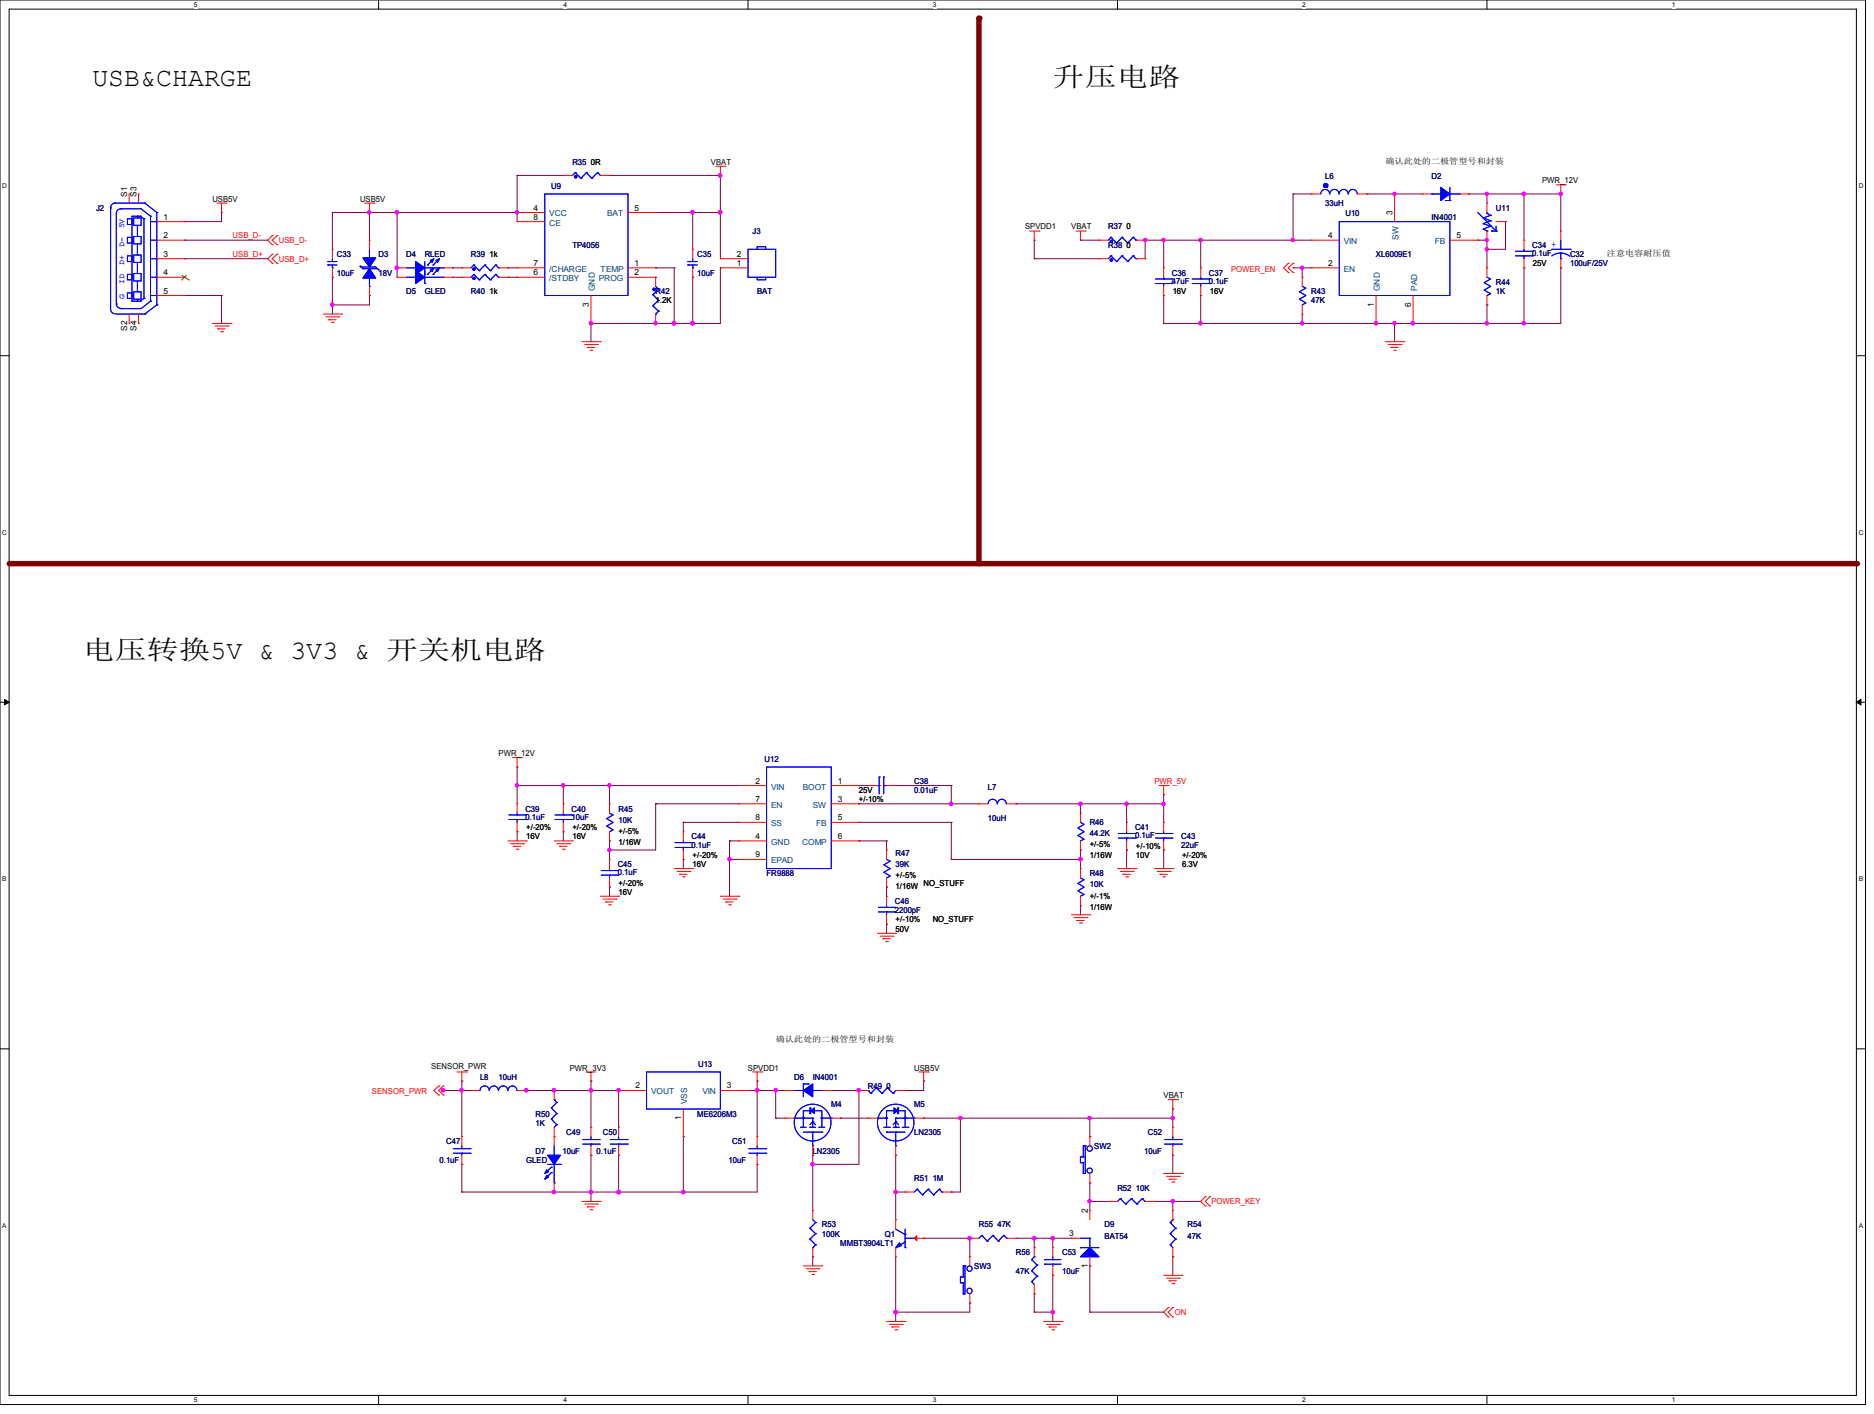
[picture p18: page 2]

D | D

# AVDD

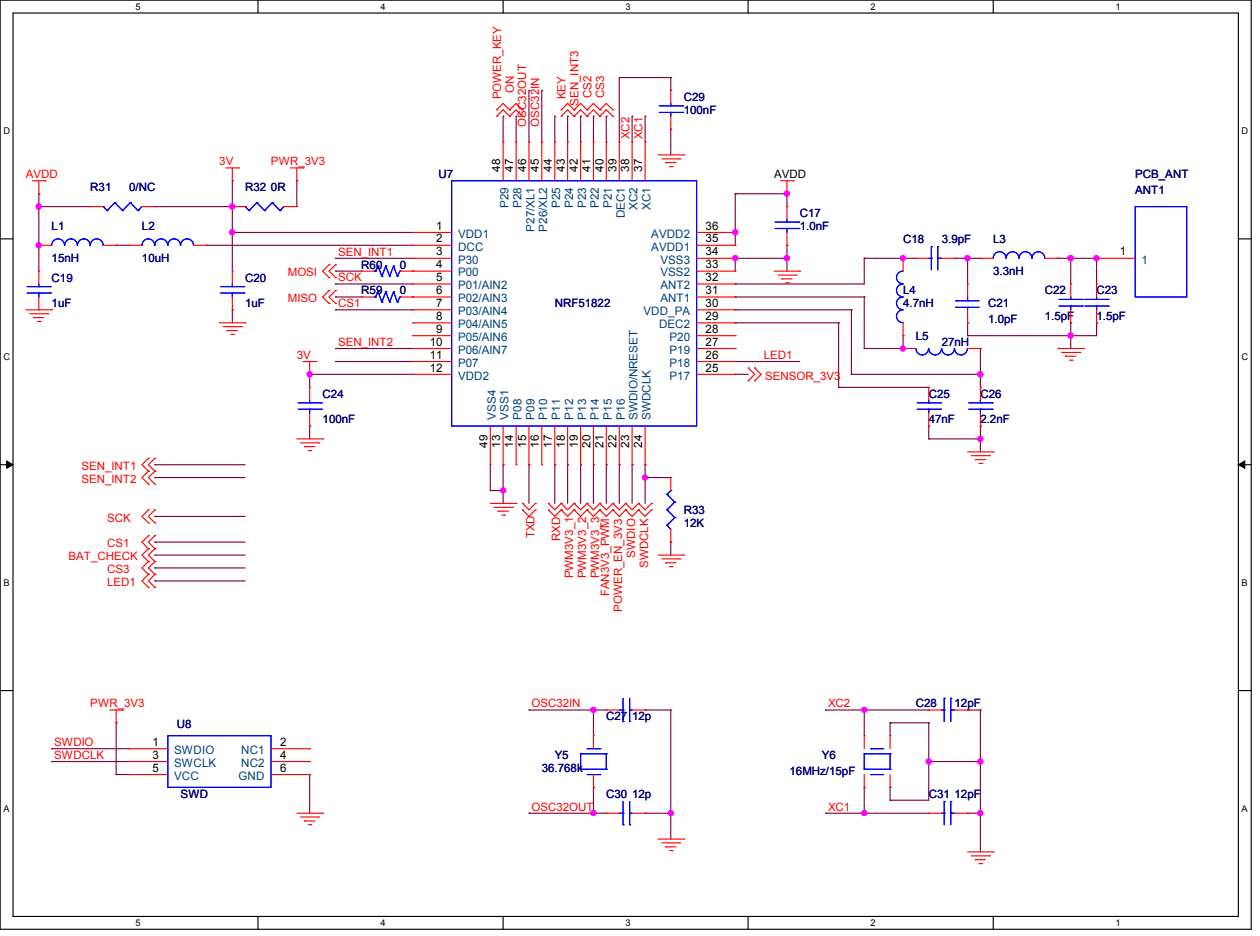
[picture p19: page 3]

# MPR7612识读模组

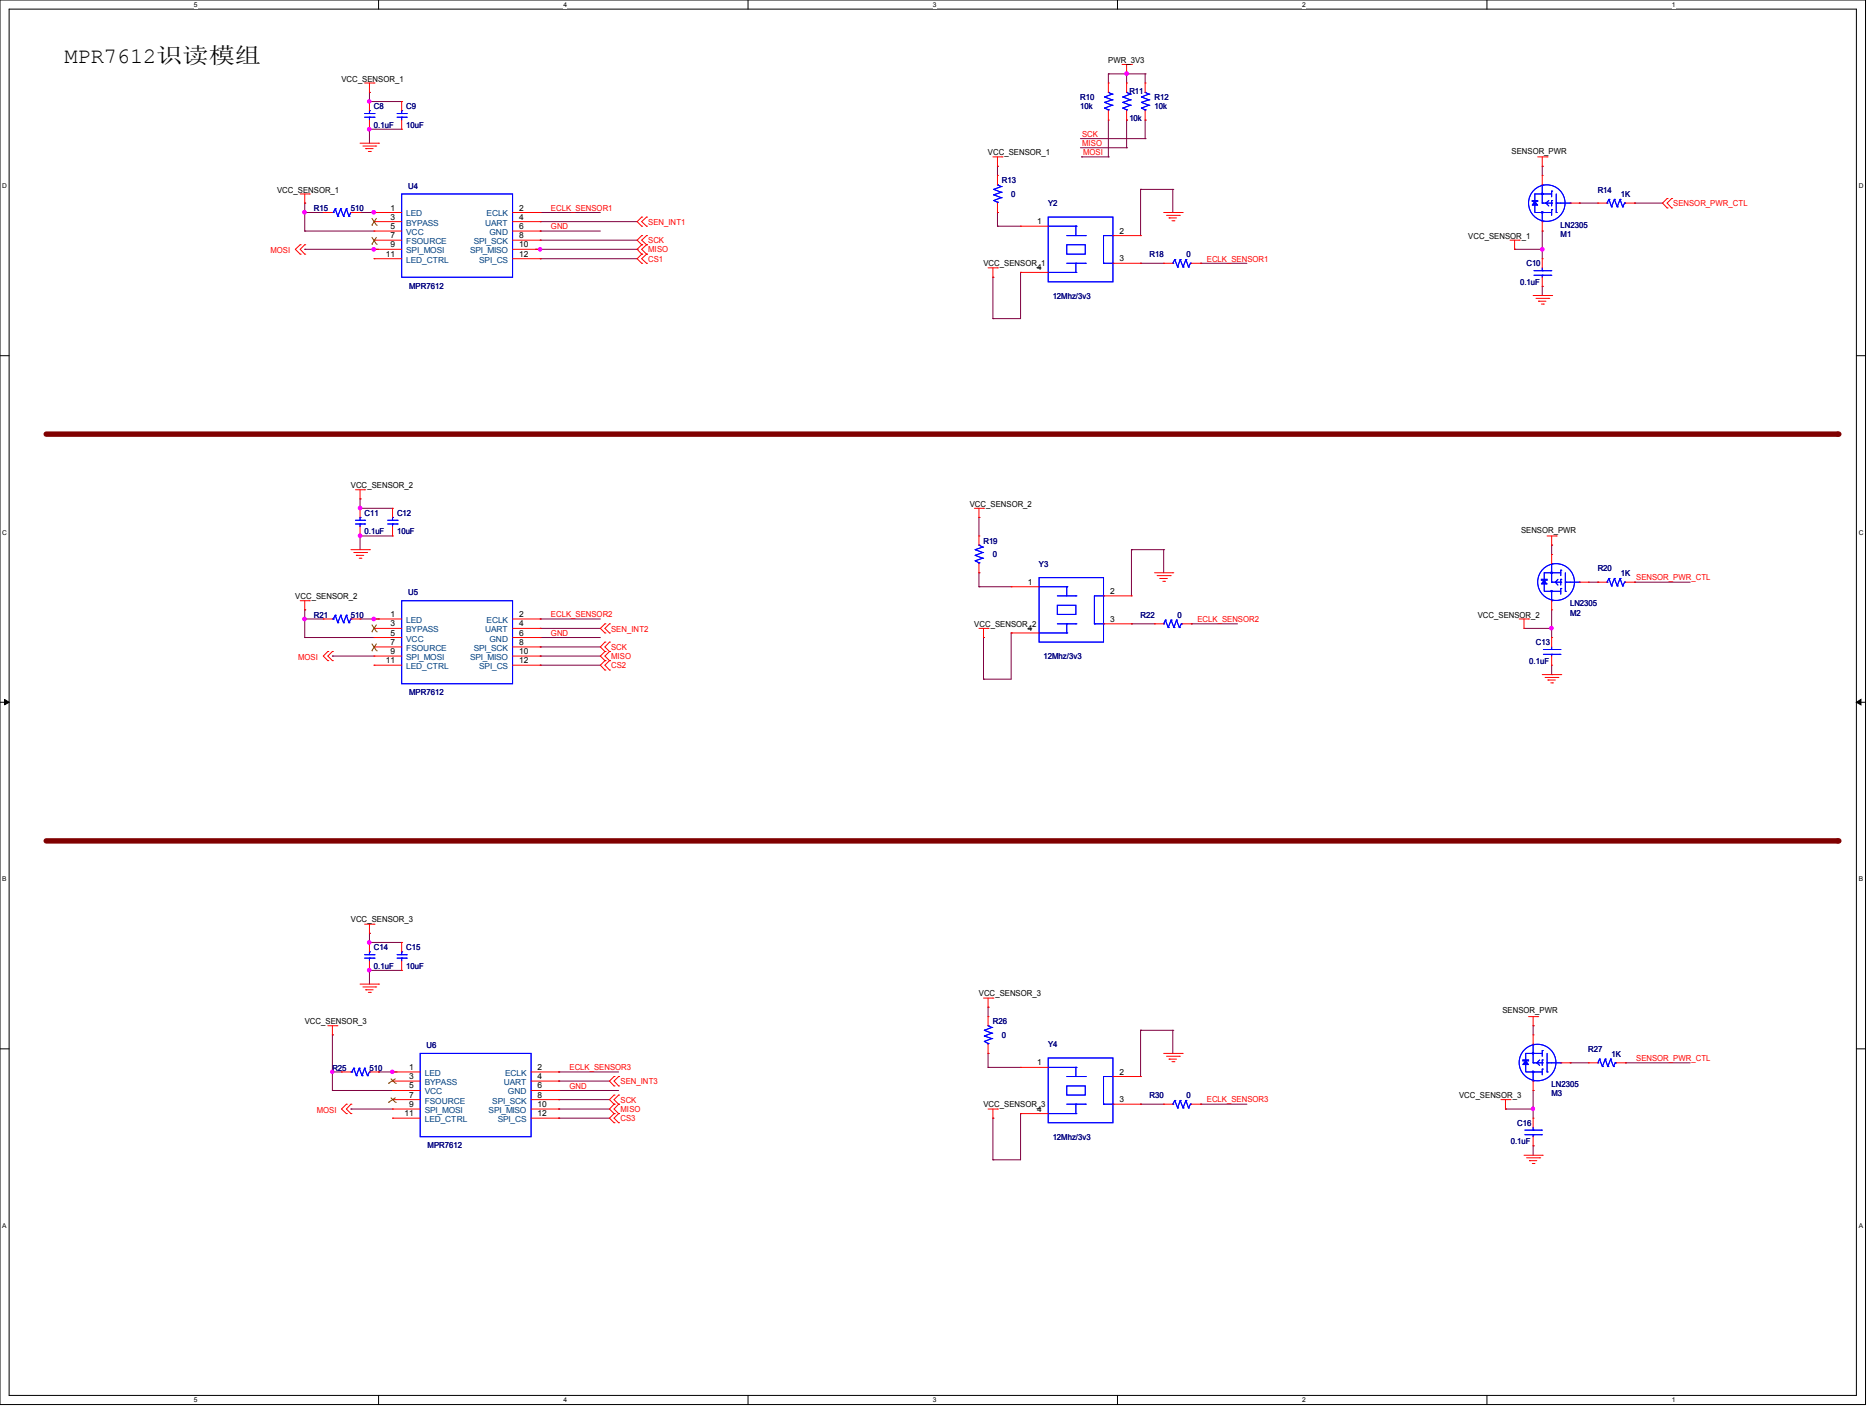
[picture p20: page 4]

D | D

# LED

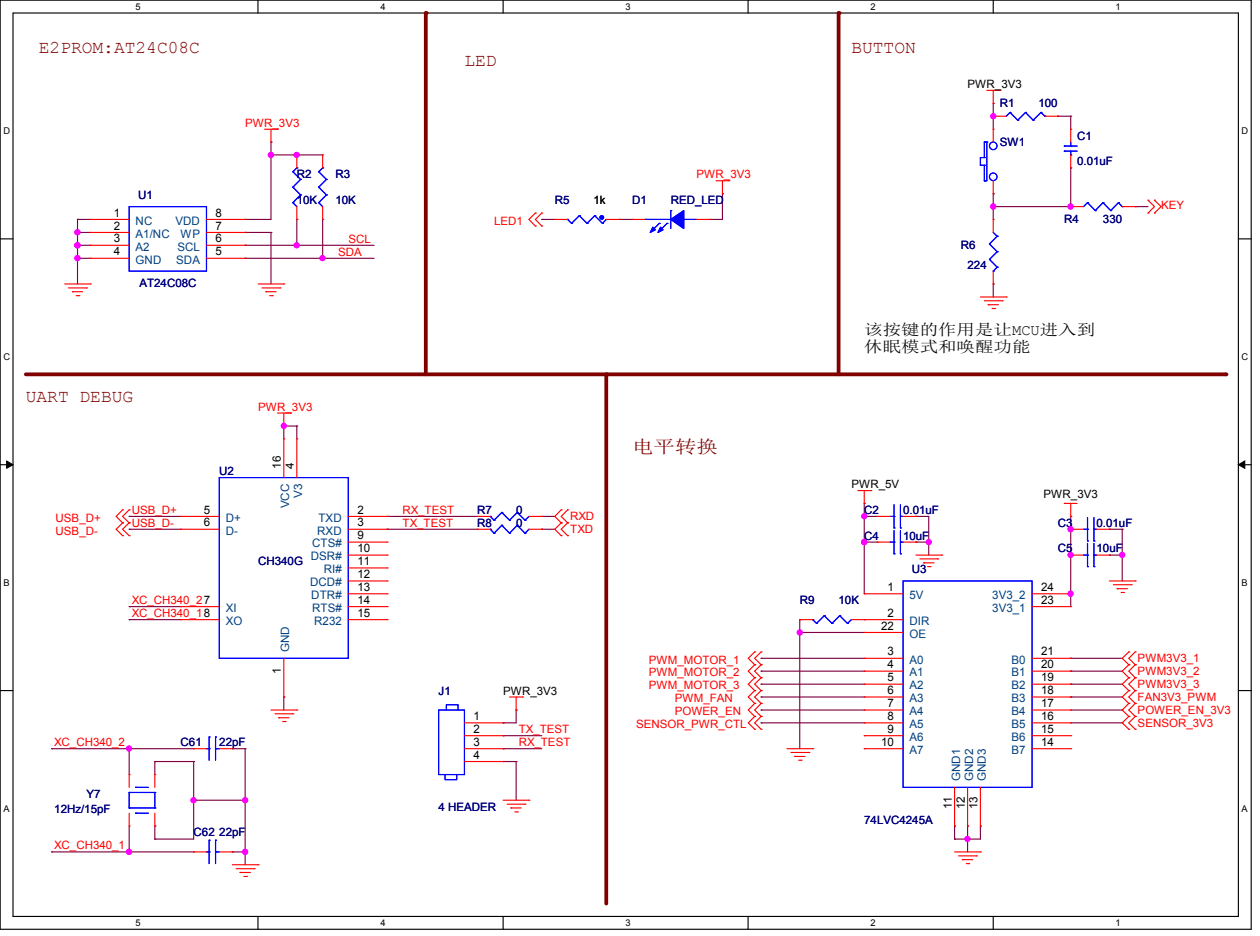
[picture p21: page 5]
