dllgxhy/ElectriSmell/(list of files, drawings)

Other design files:
hardware/v30/ELECTRISMELL0429.pcb
hardware/v30/ELECTRISMELL.DSN
hardware/v40/ELECTRISMELL_V40.DSN
hardware/v40/ELECTRISMELL_V40.pcb
hardware/v40/ELECTRISMELL_V41.pcb
hardware/v50/ELESMELL_V50.DSN
hardware/v60/ELESMELL_V60.DSN
hardware/v60/ELESMELL_V60.pcb
