dllgxhy/ElectriSmell/embed_software/finsh/debug.h

#ifndef __DEBUG_H
#define __DEBUG_H

#define	NORM_DBG	        (1<<0)
#define OTHER_DBG	        (1<<1)


#define	ON_OFF_NORM_DBG 	(1)
#define ON_OFF_OTHER_DBG	(2)
#define ON_ALL_DEBUG        (30)
#define OFF_ALL_DEBUG       (31)


#endif
