dllgxhy/ElectriSmell/(commit log)

2016-07-26 elesmell的硬件软件代码
    [ELECTRISMELL.DSN, ELECTRISMELL0429.pcb, ELECTRISMELL0504.dxf, ELECTRISMELL_V40.DSN, ELECTRISMELL_V40.dxf, ELECTRISMELL_V40.pcb, ELECTRISMELL_V41.pcb, ELESMELL_V50 - 副本.DSN]
2016-07-26 删除不必要文件
    [ELESMELL_V50 - 副本.DSN, ELESMELL_V50_v1 - 副本.pcb, ELESMELL_V50_v1.pcb, default.pcb, elesmell_v50.opj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]
2016-07-28 更改电容的容值
    [ELESMELL_V50.DSN, bom_v50.xls]
2016-09-08 增加第6版的硬件开发设计资料
    [ELESMELL_V50.pcb, ELESMELL_V60.DSN, bom_v50.xls]
2016-11-09 离职前工作整理
    [ELESMELL_V60.pcb]
