dllgxhy/ElectriSmell/(notices)

Notices in the files:
embed_software/HARDWARE/LED/led.c:
Copyright(C) ¹ãÖÝÊÐÐÇÒíµç×Ó¿Æ¼¼ÓÐÏÞ¹«Ë¾ 2009-2019
All rights reserved
